smc8050/MSFS2020_Homecockpit/README.md

# MSFS2020 Homecockpit
The aim of this project was to build a home cockpit working together with Microsoft Flight Simulator 2020.
A "How to use it" will be published in future...

The PCB files are best viewed on [cadlab.io](https://cadlab.io/project/23795/main/files/PCB)
