smc8050/MSFS2020_Homecockpit/Code/README.md

# Code Directory

This directory contains the code for the Arduino and Python program which are use to send the button commands from the cockpitpanel to the Flight Simulator.

Further information will follow...
