smc8050/MSFS2020_Homecockpit/PCB/documentation/README.md

# PCB Documentation

This directry contains the documentation for all PCB relatet informations.
