smc8050/MSFS2020_Homecockpit/Code/Python/Python_code.md

# Python Code
This directory contains all the code for evaluating the inputs from th Arduino and send the correct SimConnect commands to MSFS2020
