smc8050/MSFS2020_Homecockpit/Code/Arduino/Arduino_readme.md

# Arduino Code
This directory contains all code for the arduino boards, where all the inputs are connected
