smc8050/MSFS2020_Homecockpit/Code/Pinout_Schematics/Light_panel_Pinout.pdf

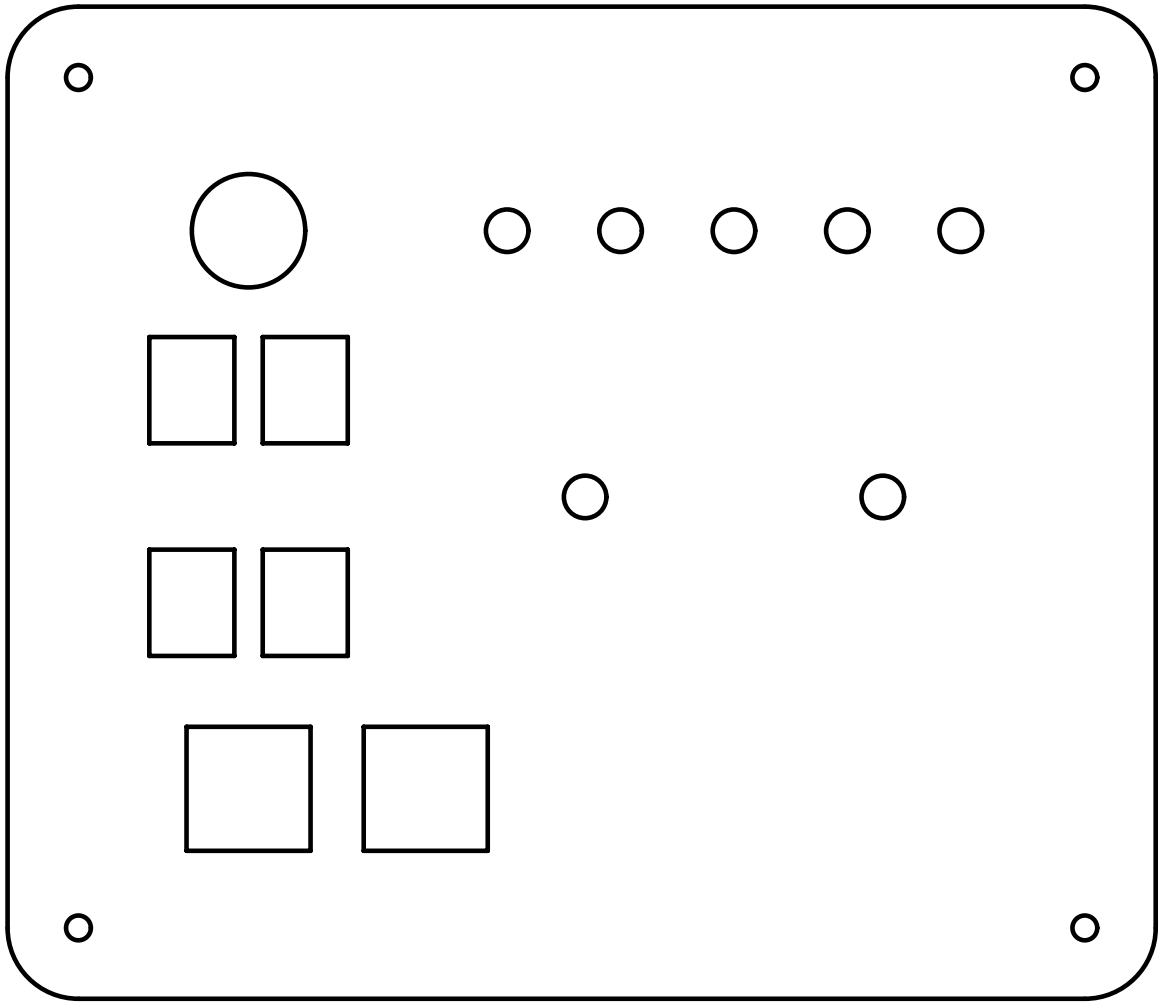
[picture p1: figure]
