smc8050/MSFS2020_Homecockpit/Code/Pinout_Schematics/Throttle_Panel_Pinout.pdf

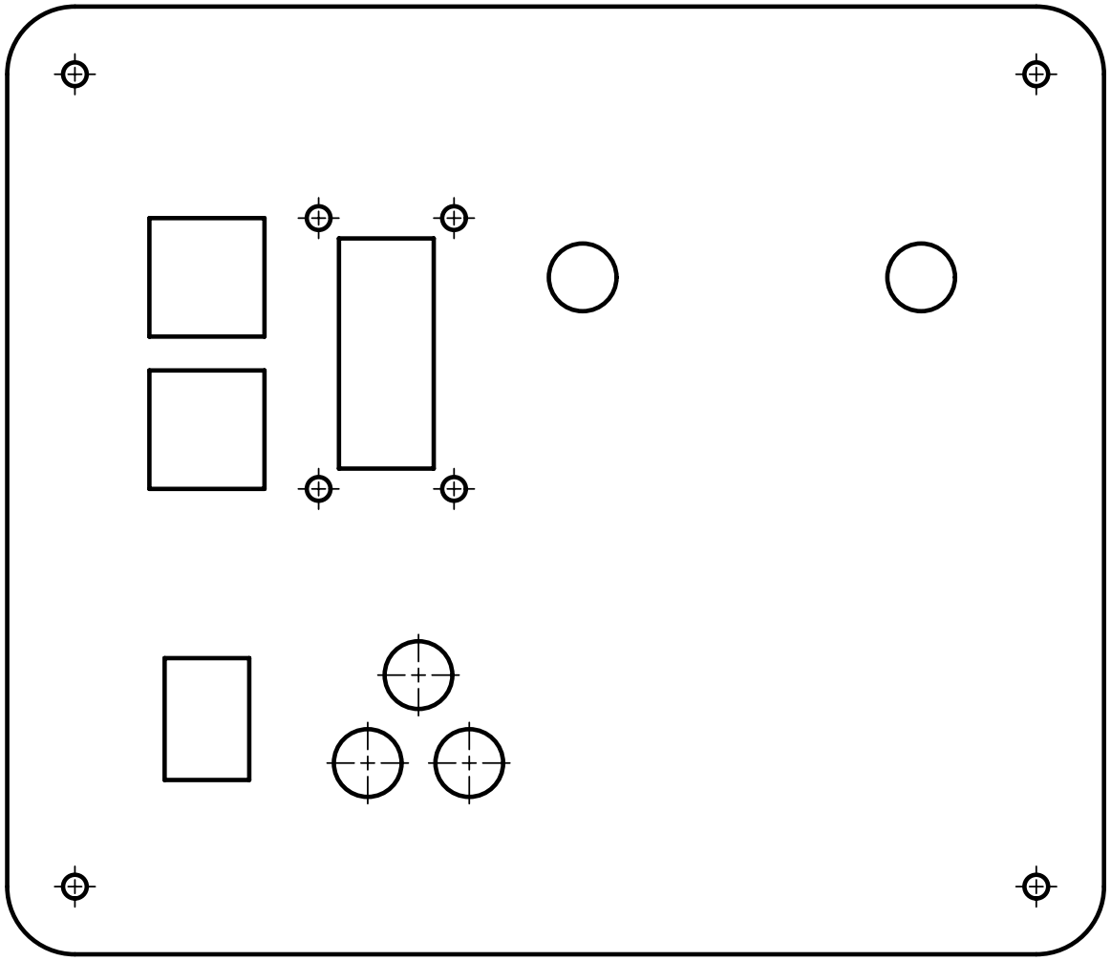
[picture p2: figure]
