smc8050/MSFS2020_Homecockpit/Code/Pinout_Schematics/Pinout_Annotated/Light_panel_Pinout.pdf

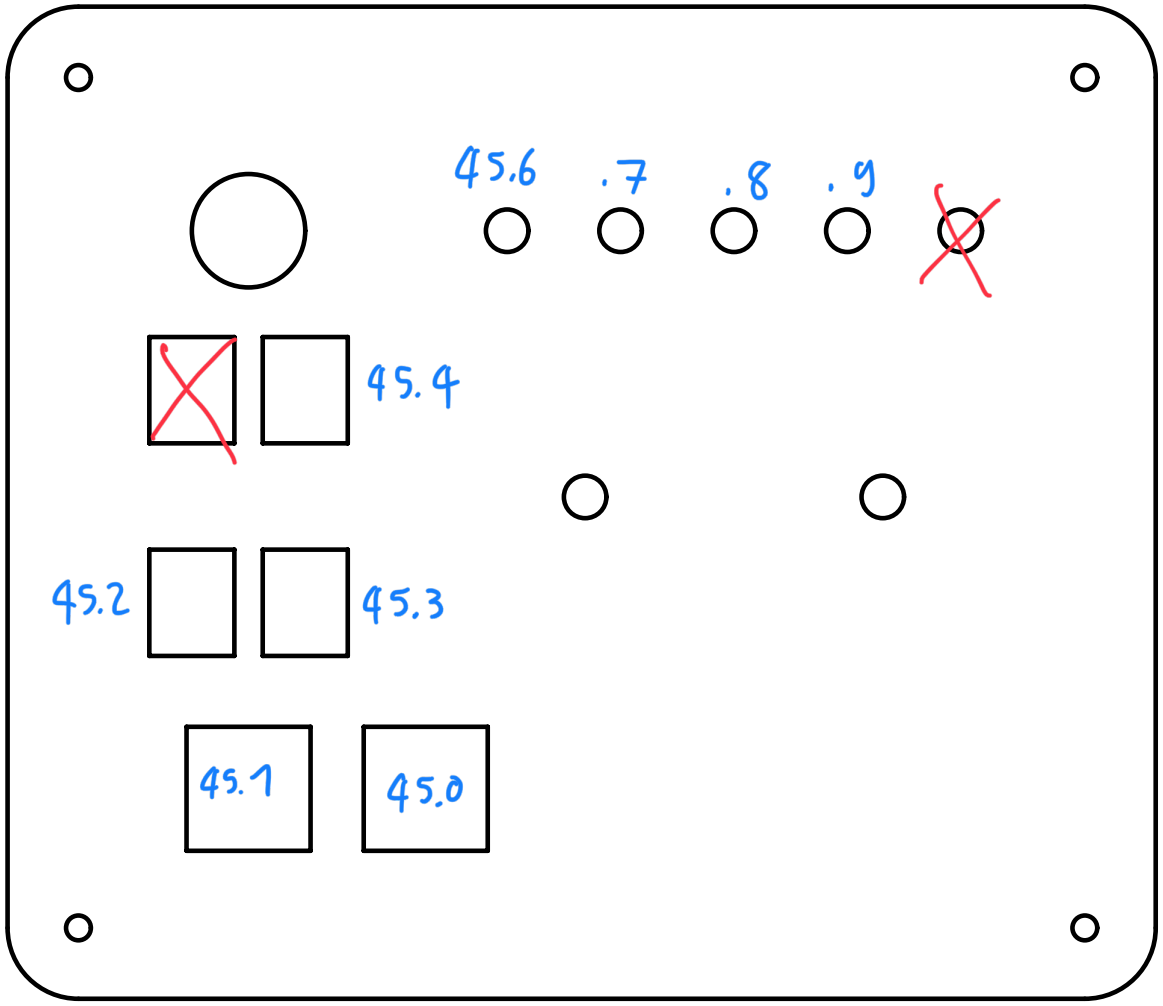
[picture p3: figure]
