smc8050/MSFS2020_Homecockpit/PCB/documentation/PCB_overview.pdf

# G1000 Panel

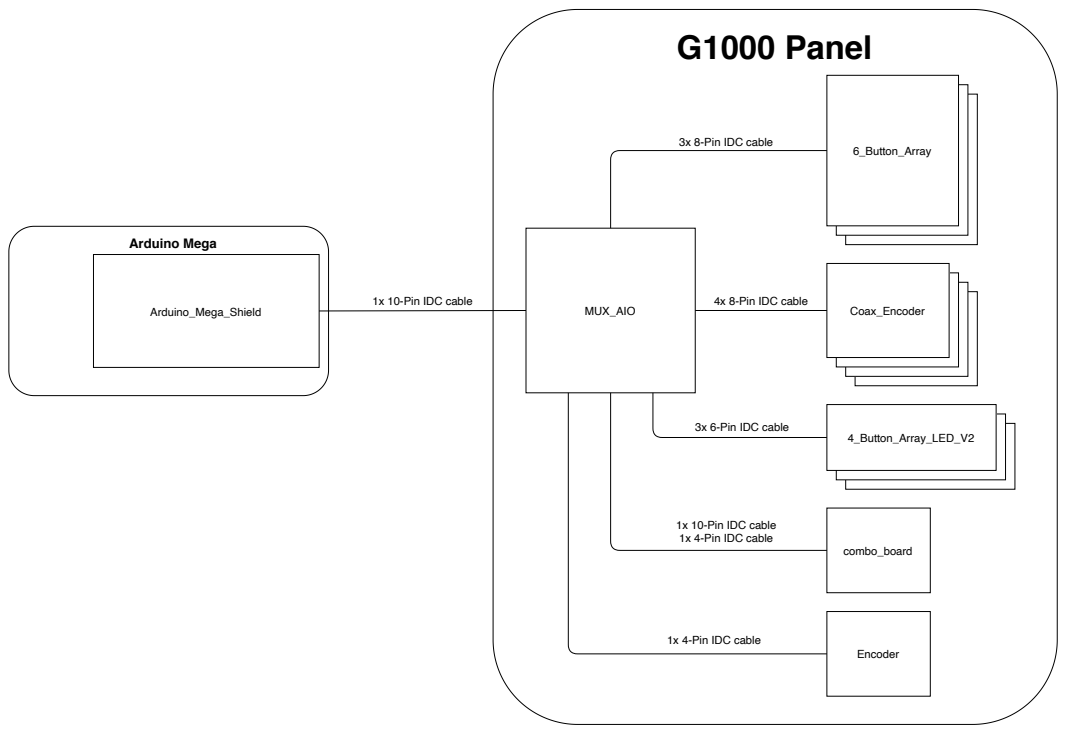
[picture p4: page 1]
4_Button_Array_LED_V2; 6_Button_Array; Coax_Encoder; combo_board; MUX_AIO; Encoder; Arduino_Mega_Shield; Arduino Mega

3x 8-Pin IDC cable

1x 10-Pin IDC cable

4x 8-Pin IDC cable

3x 6-Pin IDC cable

1x 4-Pin IDC cable
