smc8050/MSFS2020_Homecockpit/Code/Pinout_Schematics/G1000_1_Pinout.pdf

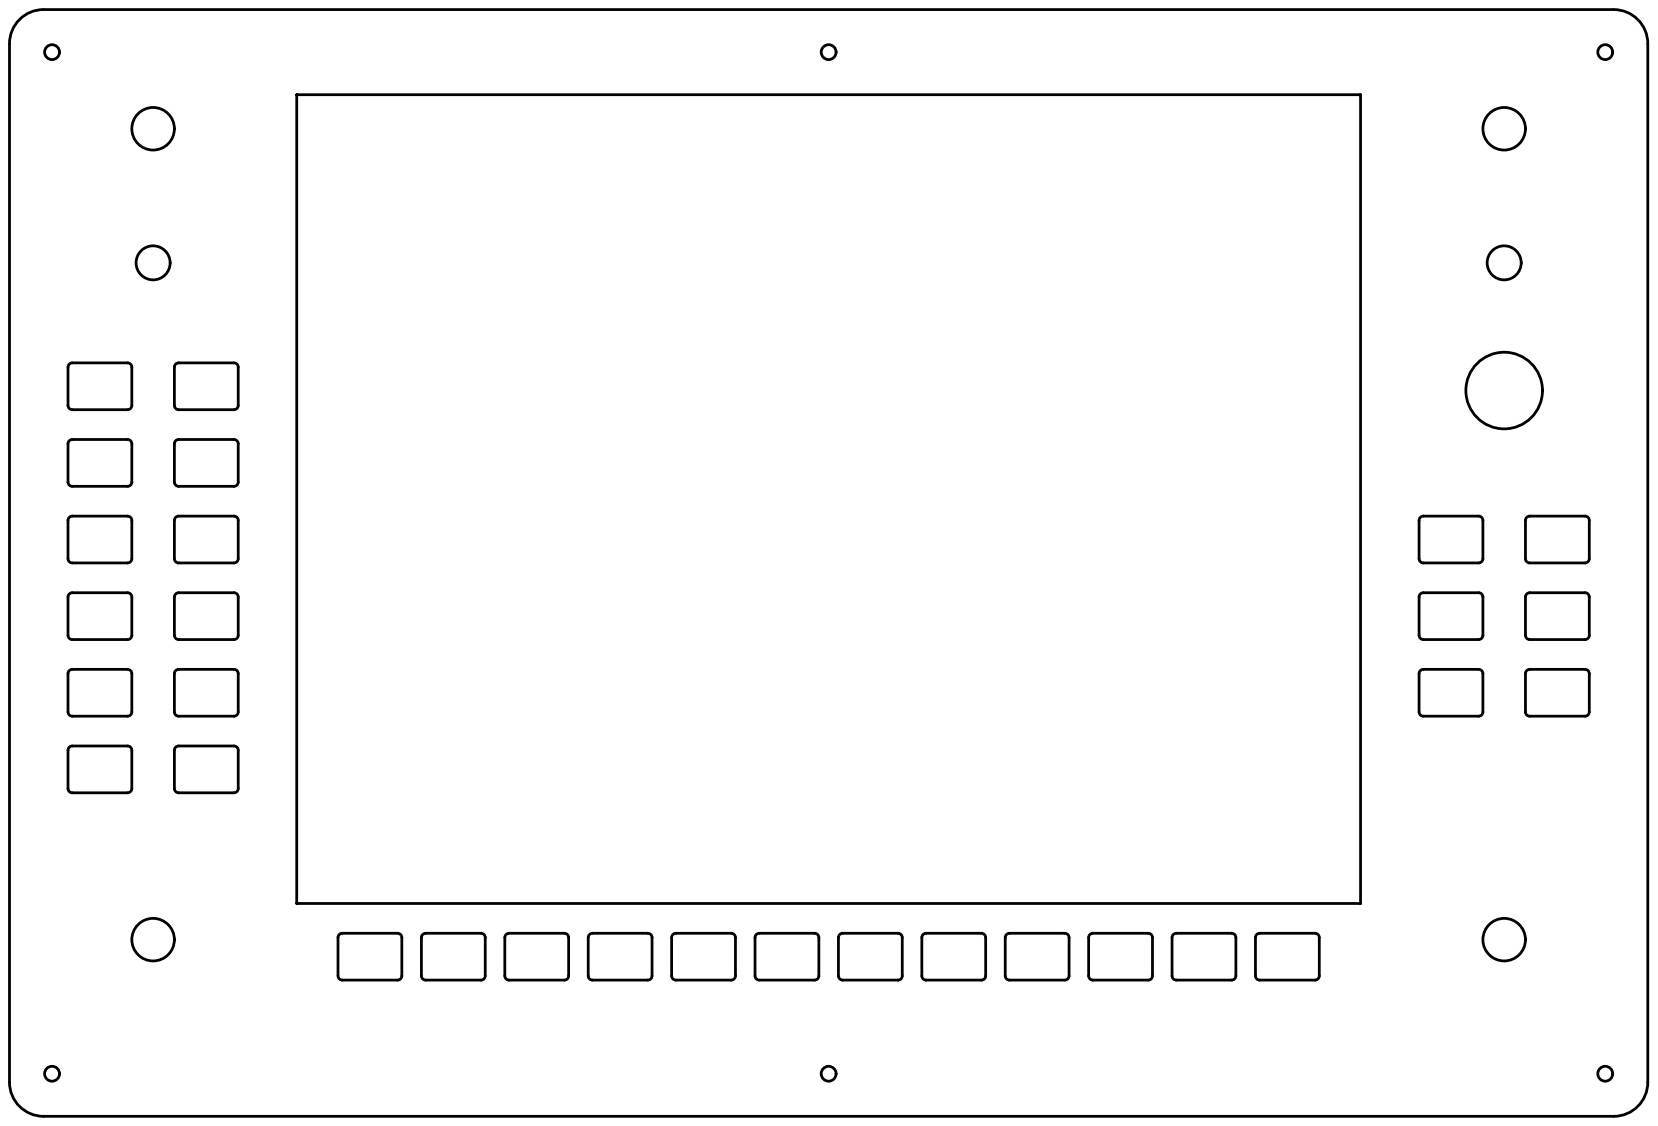
[picture p5: page 1]
