smc8050/MSFS2020_Homecockpit/Code/Pinout_Schematics/G1000_2_Pinout.pdf

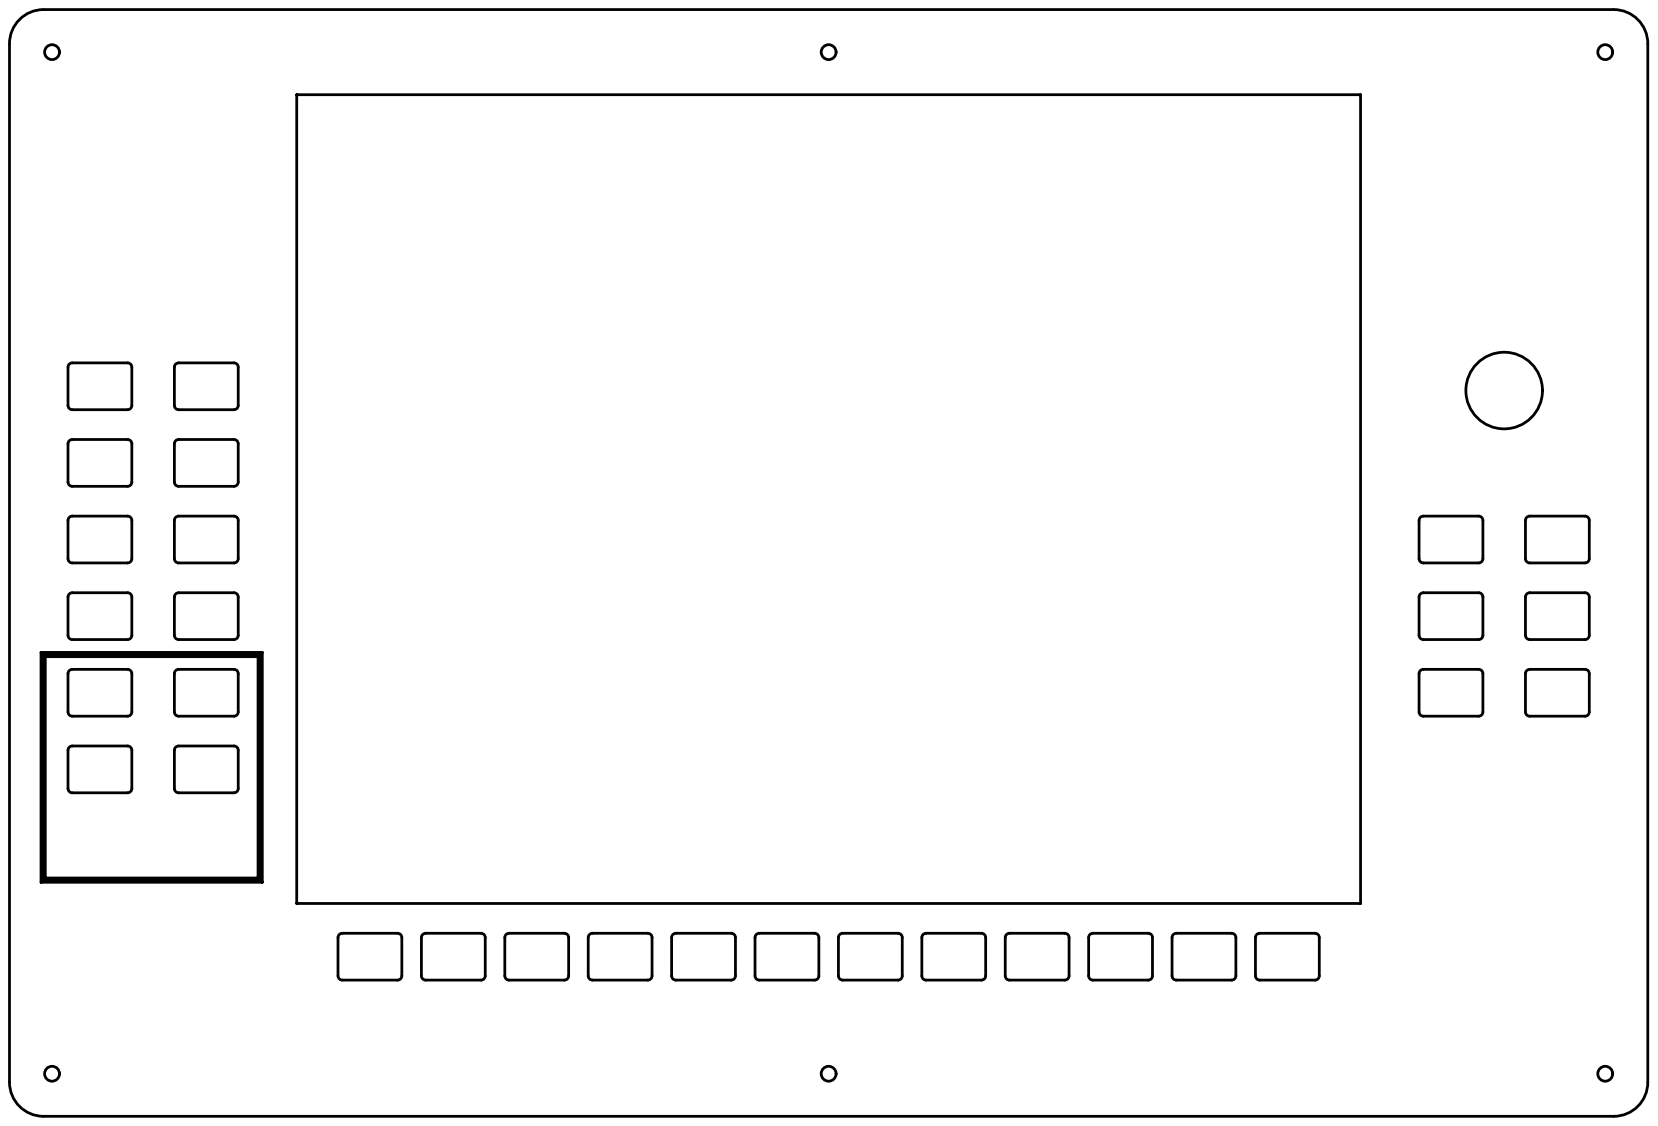
[picture p6: page 1]
