smc8050/MSFS2020_Homecockpit/Code/Pinout_Schematics/Pinout_Annotated/G1000_1_Pinout.pdf

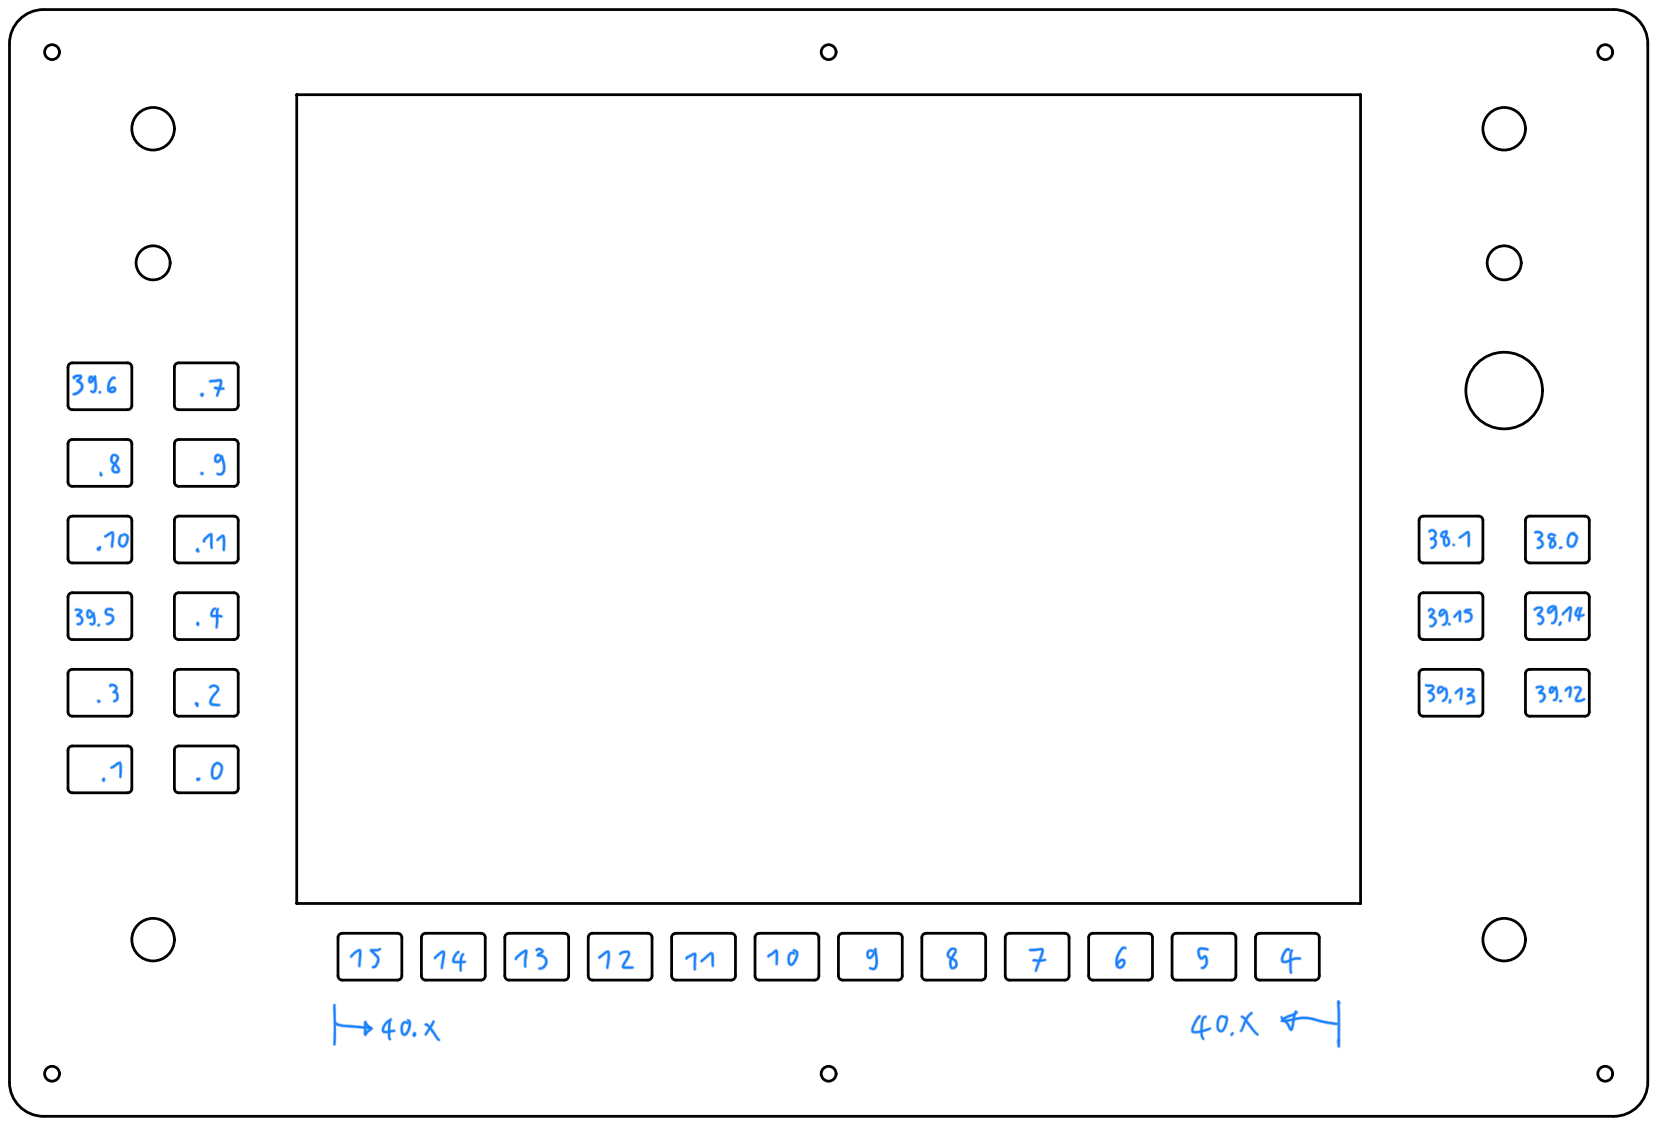
[picture p7: page 1]
