smc8050/MSFS2020_Homecockpit/Code/Pinout_Schematics/Pinout_Annotated/G1000_2_Pinout.pdf

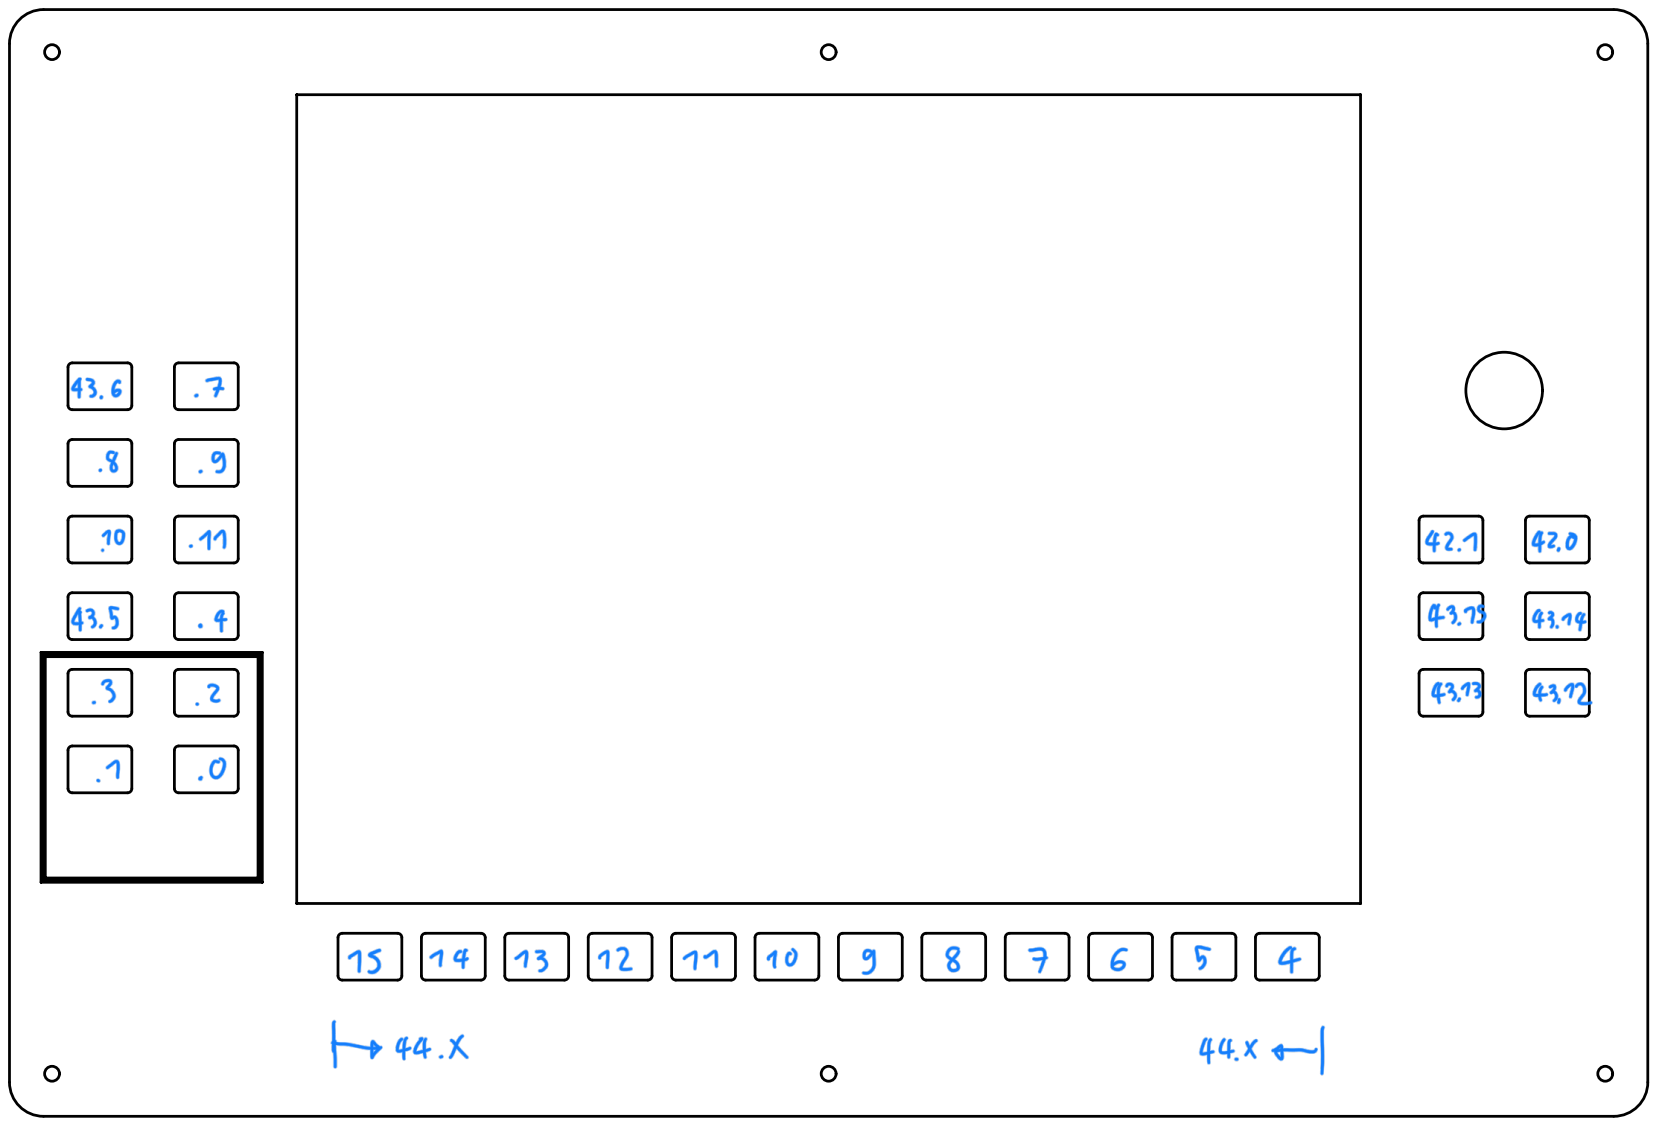
[picture p8: page 1]
