smc8050/MSFS2020_Homecockpit/PCB/projects/6_Button_Array/6_Button_Array.brd

## EAGLE design PCB/projects/6_Button_Array/6_Button_Array.brd (2021-01-24)

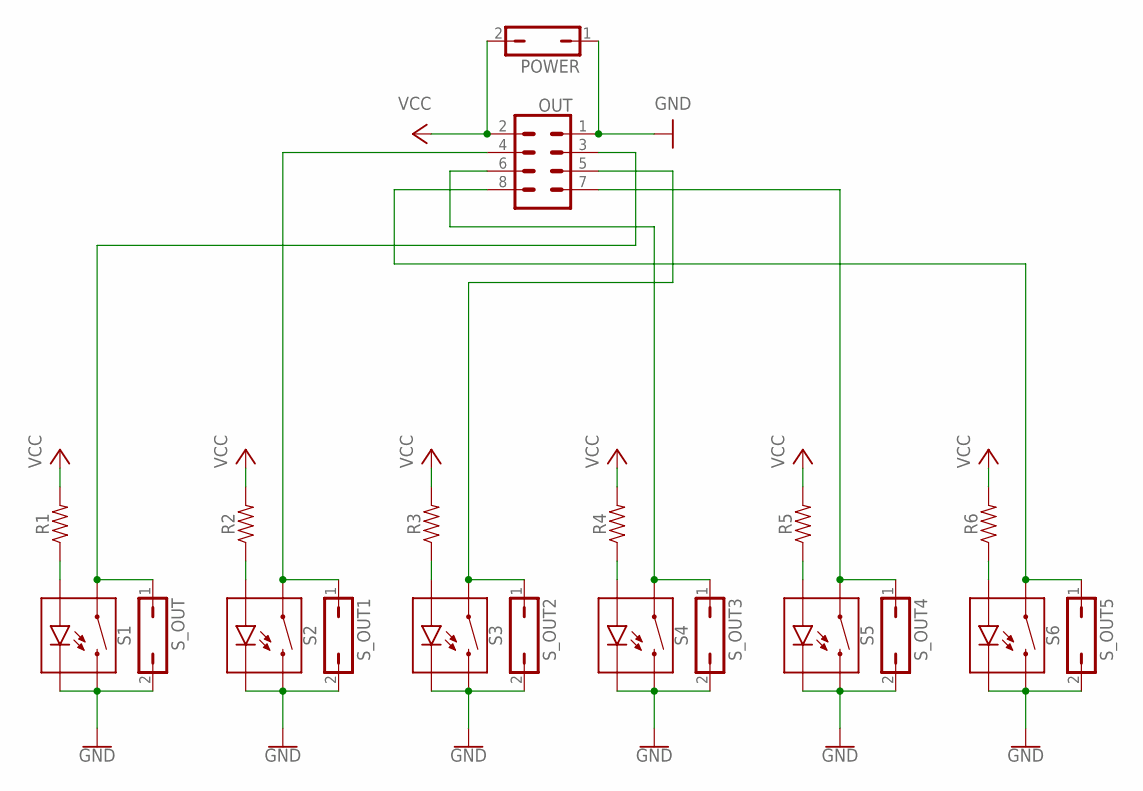
[picture p9: schematic 6_Button_Array.sch]

Parts:
OUT: CONN_04X2; 2X4
POWER: JP1Q; JP1
R1, R2, R3, R4, R5, R6: 1206
S1, S2, S3, S4, S5, S6: MOMENTARY-SWITCH-SPST-LED-PTH-12MM; TACTILE_SWITCH_LED_PTH_12MM
S_OUT, S_OUT1, S_OUT2, S_OUT3, S_OUT4, S_OUT5: JP1Q; JP1

Connections:
GND: OUT.1, POWER.1, S1.2, S1.C, S2.2, S2.C, S3.2, S3.C, S4.2, S4.C, S5.2, S5.C, S6.2, S6.C, S_OUT.2, S_OUT1.2, S_OUT2.2, S_OUT3.2, S_OUT4.2, S_OUT5.2
unnamed: R1.1, S1.A
unnamed: R2.1, S2.A
unnamed: R3.1, S3.A
unnamed: OUT.5, S3.4 (1), S_OUT2.1
unnamed: R4.1, S4.A
unnamed: OUT.6, S4.4 (1), S_OUT3.1
unnamed: R5.1, S5.A
unnamed: OUT.7, S5.4 (1), S_OUT4.1
unnamed: R6.1, S6.A
unnamed: OUT.3, S1.4 (1), S_OUT.1
unnamed: OUT.8, S6.4 (1), S_OUT5.1
unnamed: OUT.4, S2.4 (1), S_OUT1.1
VCC: OUT.2, POWER.2, R1.2, R2.2, R3.2, R4.2, R5.2, R6.2

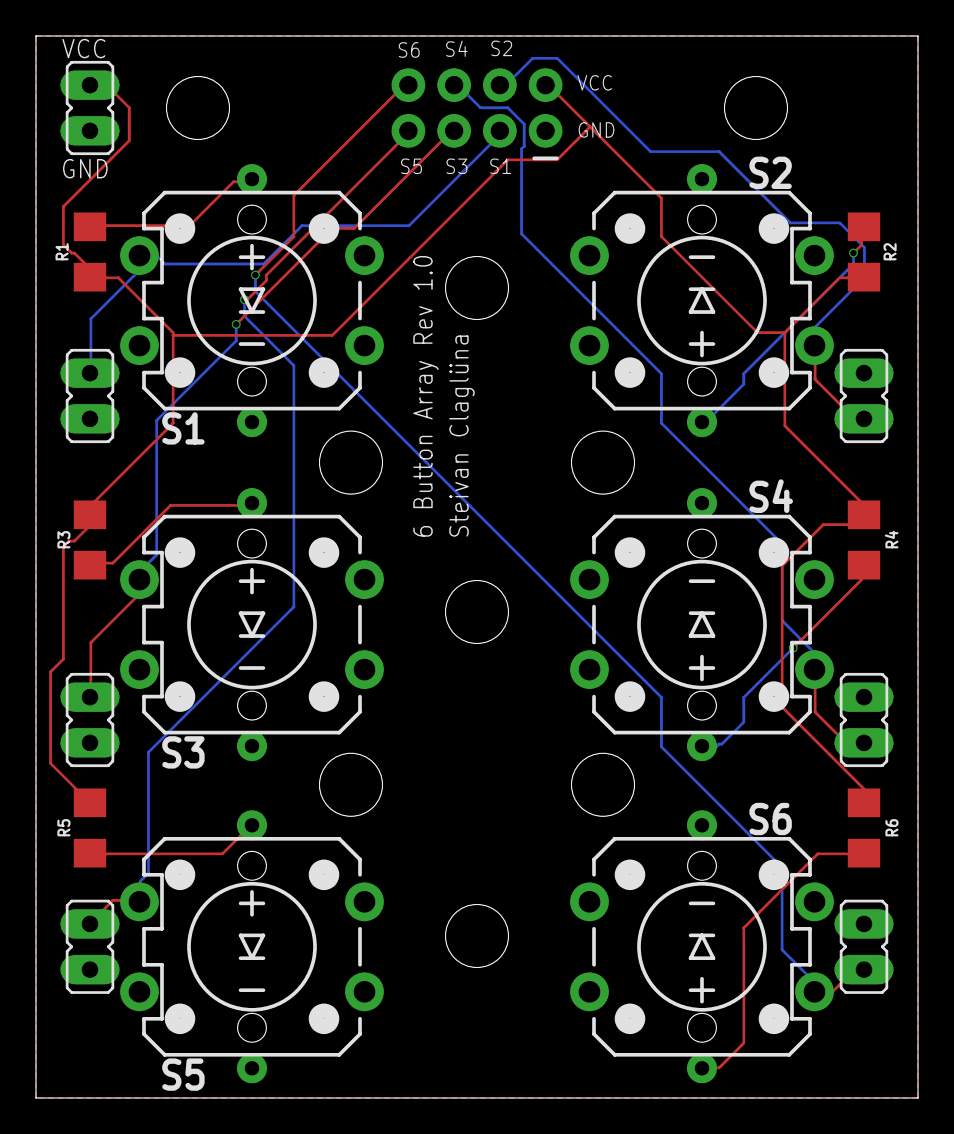
[picture p10: board 6_Button_Array.brd from above]

Board: 2 copper layers, 49.0 x 59.0 mm, 20 parts (1 on the bottom side), 14 nets.
