smc8050/MSFS2020_Homecockpit/PCB/projects/Coax_Encoder/Coax_Encoder.brd

## EAGLE design PCB/projects/Coax_Encoder/Coax_Encoder.brd (2021-01-24)

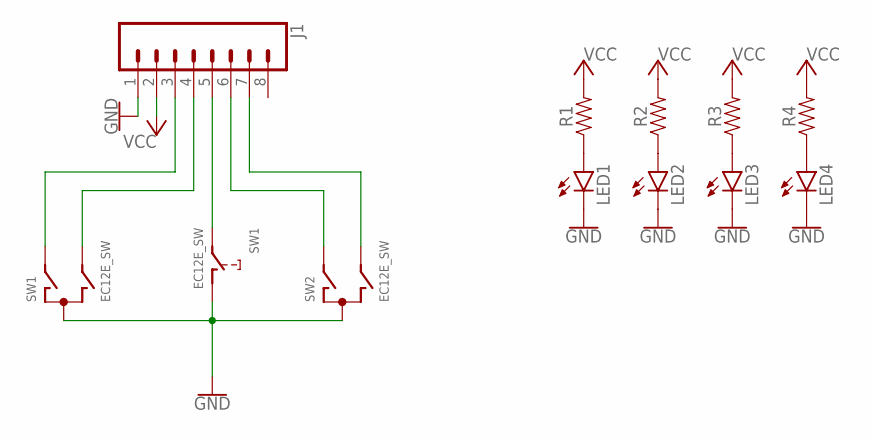
[picture p11: schematic Coax_Encoder.sch]

Parts:
J1: CONN_08"; 1X08
LED1, LED2, LED3, LED4: LED3MM
R1, R2, R3, R4: 1206
SW1, SW2: EC12E_SW; ALPS_EC12E_SW

Connections:
GND: J1.1, LED1.K (C), LED2.K (C), LED3.K (C), LED4.K (C), SW1.C, SW1.D (1), SW2.C
unnamed: J1.3, SW1.A
unnamed: J1.4, SW1.B
unnamed: J1.5, SW1.E (2)
unnamed: J1.6, SW2.A
unnamed: J1.7, SW2.B
unnamed: LED1.A, R1.1
unnamed: LED2.A, R2.1
unnamed: LED3.A, R3.1
unnamed: LED4.A, R4.1
VCC: J1.2, R1.2, R2.2, R3.2, R4.2

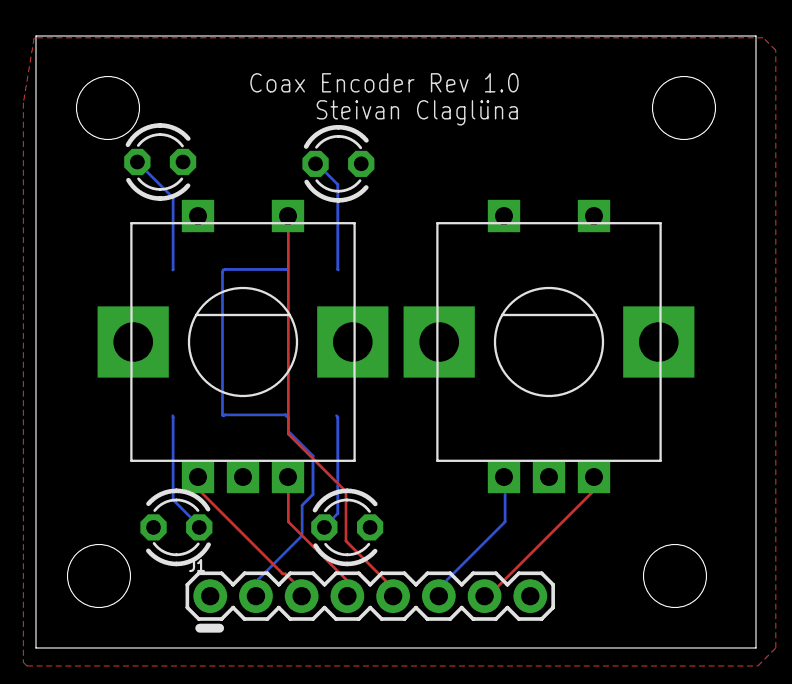
[picture p12: board Coax_Encoder.brd from above]

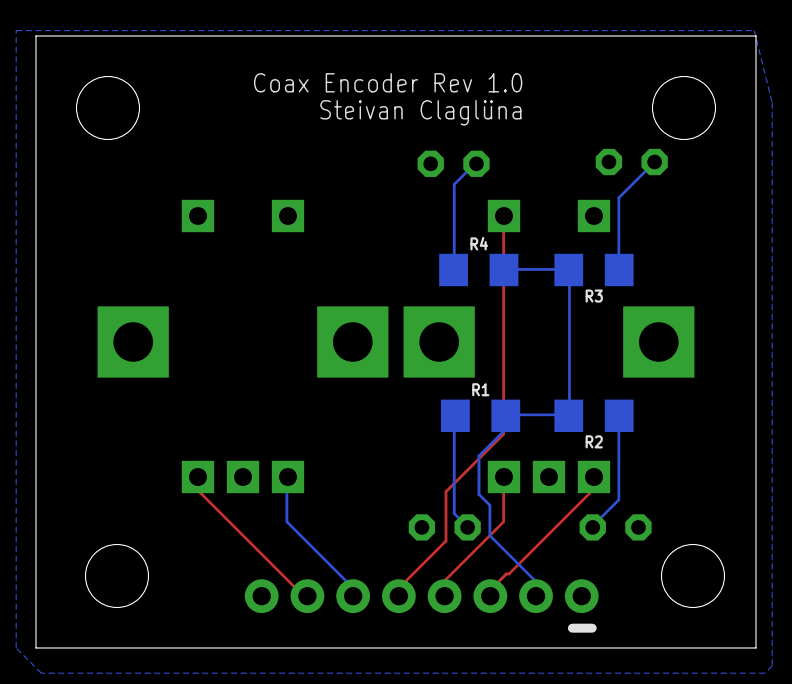
[picture p13: board Coax_Encoder.brd from below]

Board: 2 copper layers, 40.0 x 34.0 mm, 11 parts (4 on the bottom side), 11 nets.
