smc8050/MSFS2020_Homecockpit/PCB/projects/Joystick/combo_board.brd

## EAGLE design PCB/projects/Joystick/combo_board.brd (2021-01-24)

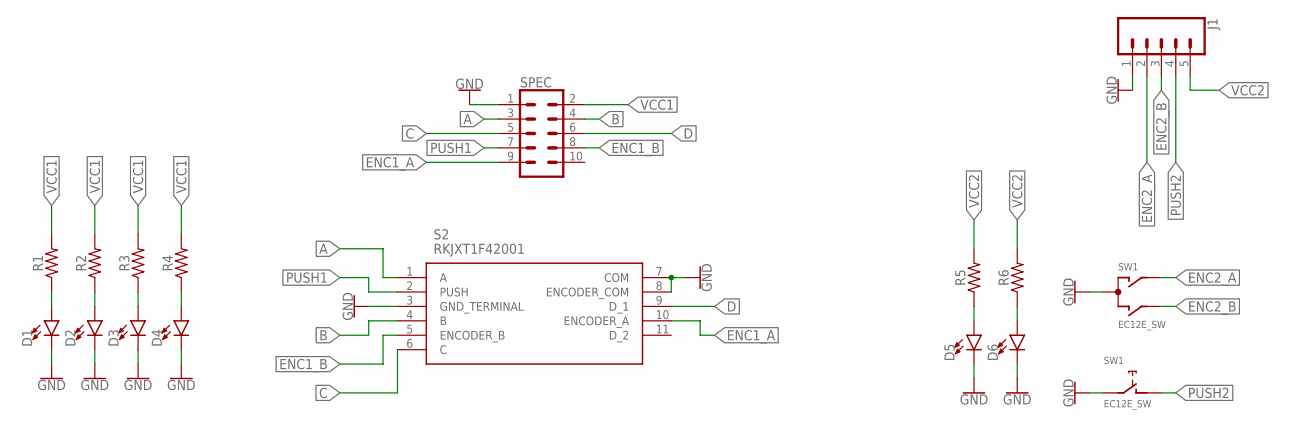
[picture p14: schematic combo_board.sch]

Parts:
D1, D2, D3, D4, D5, D6: LED-3MM-NO_SILK; LED_3MM-NS
J1: CONN_05; 1X05
R1, R2, R3, R4, R5, R6: 1206
S2: RKJXT1F42001
SPEC: CONN_05X2PTH; 2X5
SW1: EC12E_SW; ALPS_EC12E_SW

Connections:
A: S2.1 (A), SPEC.3
B: S2.4 (B), SPEC.4
C: S2.6 (C), SPEC.5
D: S2.9 (D_1), SPEC.6
ENC1_A: S2.10 (ENCODER_A), SPEC.9
ENC1_B: S2.5 (ENCODER_B), SPEC.8
ENC2_A: J1.2, SW1.A
ENC2_B: J1.3, SW1.B
GND: D1.K (C), D2.K (C), D3.K (C), D4.K (C), D5.K (C), D6.K (C), J1.1, S2.3 (GND_TERMINAL), S2.7 (COM), S2.8 (ENCODER_COM), SPEC.1, SW1.C, SW1.E (2)
unnamed: D1.A, R1.1
unnamed: D2.A, R2.1
unnamed: D3.A, R3.1
unnamed: D4.A, R4.1
unnamed: D5.A, R5.1
unnamed: D6.A, R6.1
PUSH1: S2.2 (PUSH), SPEC.7
PUSH2: J1.4, SW1.D (1)
VCC1: R1.2, R2.2, R3.2, R4.2, SPEC.2
VCC2: J1.5, R5.2, R6.2

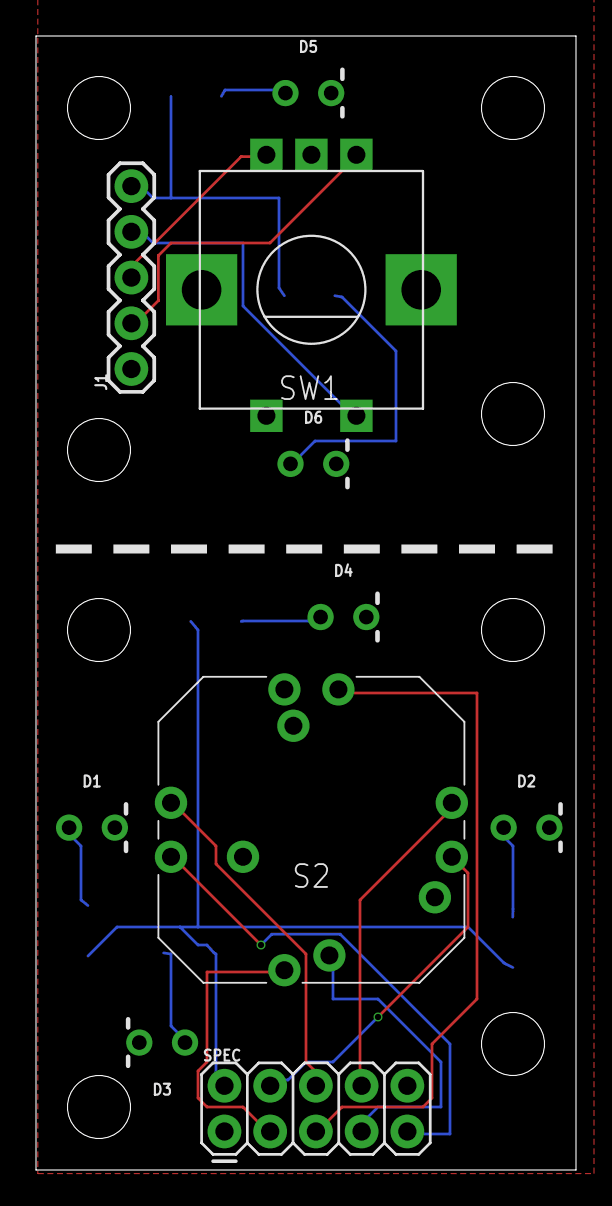
[picture p15: board combo_board.brd from above]

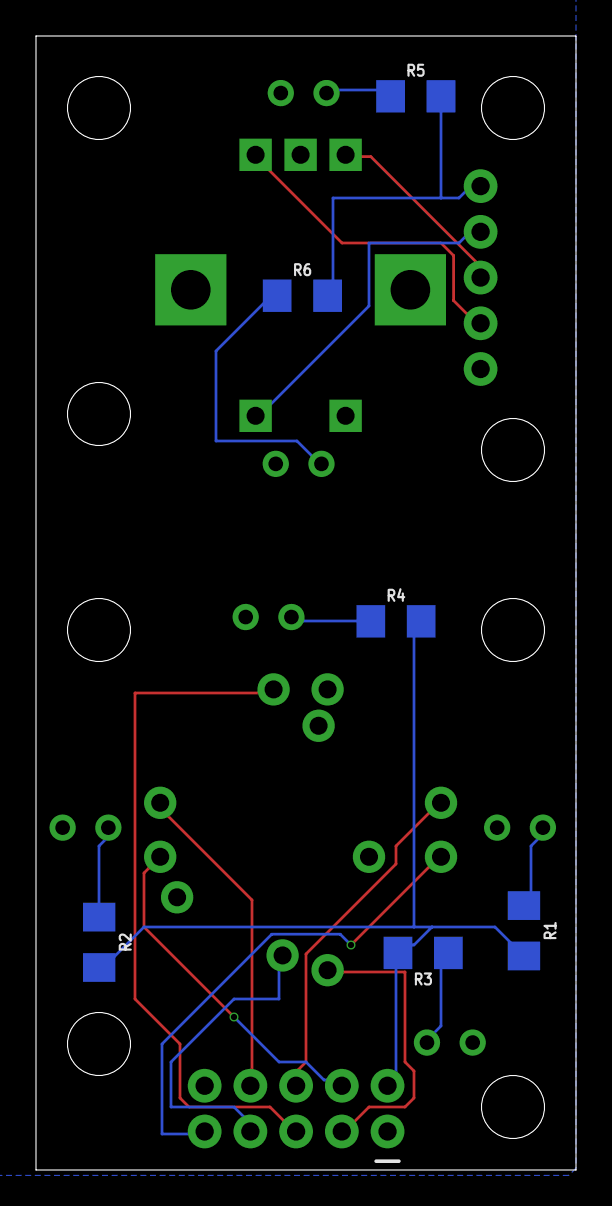
[picture p16: board combo_board.brd from below]

Board: 2 copper layers, 30.0 x 63.0 mm, 16 parts (6 on the bottom side), 19 nets.
