smc8050/MSFS2020_Homecockpit/PCB/projects/MUX_AIO/MUX_Adapter.brd

## EAGLE design PCB/projects/MUX_AIO/MUX_Adapter.brd (2021-01-24)

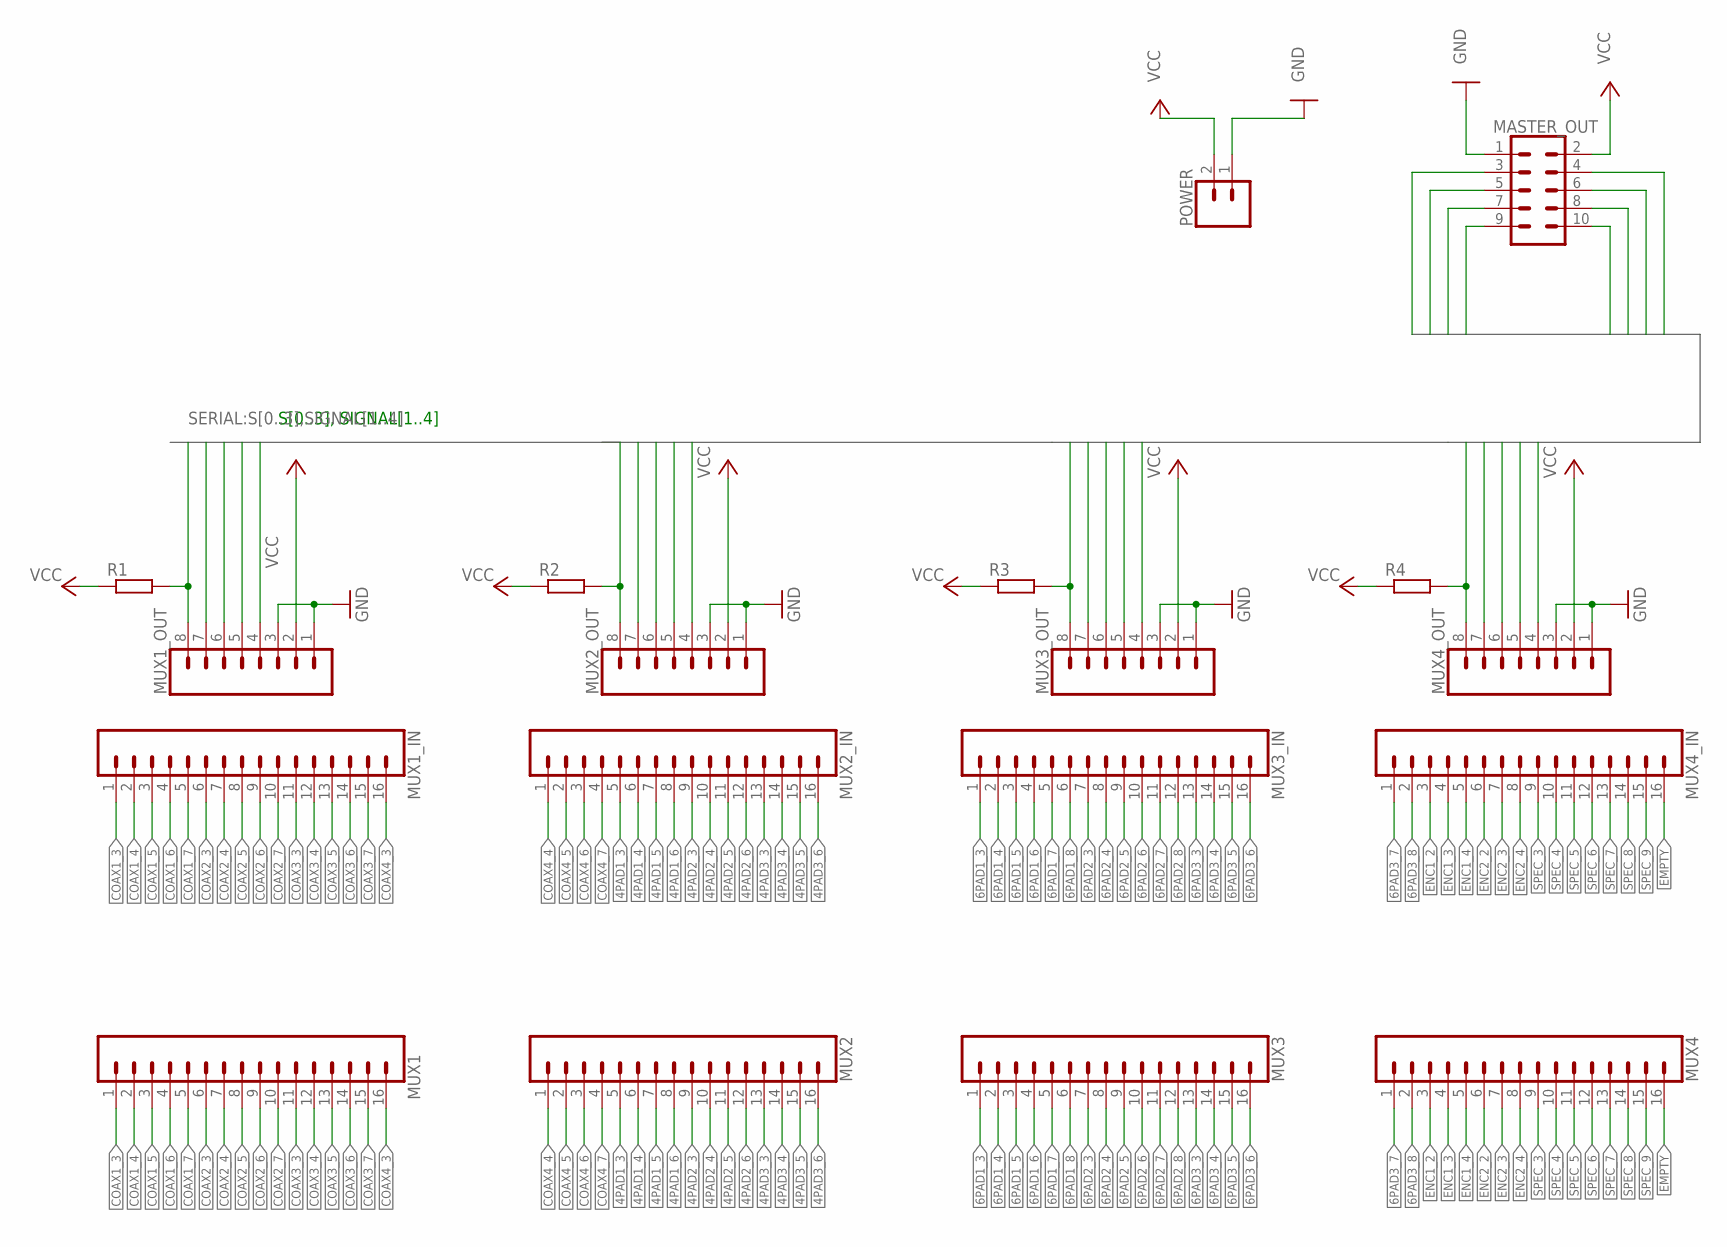
[picture p17: schematic MUX_Adapter.sch, sheet 1, MUX Routing]

Parts:
MASTER_OUT: CONN_05X2SHD-NS; 2X5-SHROUDED-NS
MUX1, MUX1_IN, MUX2, MUX2_IN, MUX3, MUX3_IN, MUX4, MUX4_IN: CONN_16; 1X16
MUX1_OUT, MUX2_OUT, MUX3_OUT, MUX4_OUT: CONN_08"; 1X08
POWER: CONN_02; 1X02
R1, R2, R3, R4: R-EU_0207/10; 0207/10

Connections:
4PAD1_3: MUX2.5, MUX2_IN.5; also elsewhere on the board
4PAD1_4: MUX2.6, MUX2_IN.6; also elsewhere on the board
4PAD1_5: MUX2.7, MUX2_IN.7; also elsewhere on the board
4PAD1_6: MUX2.8, MUX2_IN.8; also elsewhere on the board
4PAD2_3: MUX2.9, MUX2_IN.9; also elsewhere on the board
4PAD2_4: MUX2.10, MUX2_IN.10; also elsewhere on the board
4PAD2_5: MUX2.11, MUX2_IN.11; also elsewhere on the board
4PAD2_6: MUX2.12, MUX2_IN.12; also elsewhere on the board
4PAD3_3: MUX2.13, MUX2_IN.13; also elsewhere on the board
4PAD3_4: MUX2.14, MUX2_IN.14; also elsewhere on the board
4PAD3_5: MUX2.15, MUX2_IN.15; also elsewhere on the board
4PAD3_6: MUX2.16, MUX2_IN.16; also elsewhere on the board
6PAD1_3: MUX3.1, MUX3_IN.1; also elsewhere on the board
6PAD1_4: MUX3.2, MUX3_IN.2; also elsewhere on the board
6PAD1_5: MUX3.3, MUX3_IN.3; also elsewhere on the board
6PAD1_6: MUX3.4, MUX3_IN.4; also elsewhere on the board
6PAD1_7: MUX3.5, MUX3_IN.5; also elsewhere on the board
6PAD1_8: MUX3.6, MUX3_IN.6; also elsewhere on the board
6PAD2_3: MUX3.7, MUX3_IN.7; also elsewhere on the board
6PAD2_4: MUX3.8, MUX3_IN.8; also elsewhere on the board
6PAD2_5: MUX3.9, MUX3_IN.9; also elsewhere on the board
6PAD2_6: MUX3.10, MUX3_IN.10; also elsewhere on the board
6PAD2_7: MUX3.11, MUX3_IN.11; also elsewhere on the board
6PAD2_8: MUX3.12, MUX3_IN.12; also elsewhere on the board
6PAD3_3: MUX3.13, MUX3_IN.13; also elsewhere on the board
6PAD3_4: MUX3.14, MUX3_IN.14; also elsewhere on the board
6PAD3_5: MUX3.15, MUX3_IN.15; also elsewhere on the board
6PAD3_6: MUX3.16, MUX3_IN.16; also elsewhere on the board
6PAD3_7: MUX4.1, MUX4_IN.1; also elsewhere on the board
6PAD3_8: MUX4.2, MUX4_IN.2; also elsewhere on the board
COAX1_3: MUX1.1, MUX1_IN.1; also elsewhere on the board
COAX1_4: MUX1.2, MUX1_IN.2; also elsewhere on the board
COAX1_5: MUX1.3, MUX1_IN.3; also elsewhere on the board
COAX1_6: MUX1.4, MUX1_IN.4; also elsewhere on the board
COAX1_7: MUX1.5, MUX1_IN.5; also elsewhere on the board
COAX2_3: MUX1.6, MUX1_IN.6; also elsewhere on the board
COAX2_4: MUX1.7, MUX1_IN.7; also elsewhere on the board
COAX2_5: MUX1.8, MUX1_IN.8; also elsewhere on the board
COAX2_6: MUX1.9, MUX1_IN.9; also elsewhere on the board
COAX2_7: MUX1.10, MUX1_IN.10; also elsewhere on the board
COAX3_3: MUX1.11, MUX1_IN.11; also elsewhere on the board
COAX3_4: MUX1.12, MUX1_IN.12; also elsewhere on the board
COAX3_5: MUX1.13, MUX1_IN.13; also elsewhere on the board
COAX3_6: MUX1.14, MUX1_IN.14; also elsewhere on the board
COAX3_7: MUX1.15, MUX1_IN.15; also elsewhere on the board
COAX4_3: MUX1.16, MUX1_IN.16; also elsewhere on the board
COAX4_4: MUX2.1, MUX2_IN.1; also elsewhere on the board
COAX4_5: MUX2.2, MUX2_IN.2; also elsewhere on the board
COAX4_6: MUX2.3, MUX2_IN.3; also elsewhere on the board
COAX4_7: MUX2.4, MUX2_IN.4; also elsewhere on the board
EMPTY: MUX4.16, MUX4_IN.16
ENC1_2: MUX4.3, MUX4_IN.3; also elsewhere on the board
ENC1_3: MUX4.4, MUX4_IN.4; also elsewhere on the board
ENC1_4: MUX4.5, MUX4_IN.5; also elsewhere on the board
ENC2_2: MUX4.6, MUX4_IN.6; also elsewhere on the board
ENC2_3: MUX4.7, MUX4_IN.7; also elsewhere on the board
ENC2_4: MUX4.8, MUX4_IN.8; also elsewhere on the board
GND: MASTER_OUT.1, MUX1_OUT.1, MUX1_OUT.3, MUX2_OUT.1, MUX2_OUT.3, MUX3_OUT.1, MUX3_OUT.3, MUX4_OUT.1, MUX4_OUT.3, POWER.1; also elsewhere on the board
S0: MASTER_OUT.3, MUX1_OUT.4, MUX2_OUT.4, MUX3_OUT.4, MUX4_OUT.4
S1: MASTER_OUT.4, MUX1_OUT.5, MUX2_OUT.5, MUX3_OUT.5, MUX4_OUT.5
S2: MASTER_OUT.5, MUX1_OUT.6, MUX2_OUT.6, MUX3_OUT.6, MUX4_OUT.6
S3: MASTER_OUT.6, MUX1_OUT.7, MUX2_OUT.7, MUX3_OUT.7, MUX4_OUT.7
SIGNAL1: MASTER_OUT.7, MUX4_OUT.8, R4.2
SIGNAL2: MASTER_OUT.8, MUX3_OUT.8, R3.2
SIGNAL3: MASTER_OUT.9, MUX2_OUT.8, R2.2
SIGNAL4: MASTER_OUT.10, MUX1_OUT.8, R1.2
SPEC_3: MUX4.9, MUX4_IN.9; also elsewhere on the board
SPEC_4: MUX4.10, MUX4_IN.10; also elsewhere on the board
SPEC_5: MUX4.11, MUX4_IN.11; also elsewhere on the board
SPEC_6: MUX4.12, MUX4_IN.12; also elsewhere on the board
SPEC_7: MUX4.13, MUX4_IN.13; also elsewhere on the board
SPEC_8: MUX4.14, MUX4_IN.14; also elsewhere on the board
SPEC_9: MUX4.15, MUX4_IN.15; also elsewhere on the board
VCC: MASTER_OUT.2, MUX1_OUT.2, MUX2_OUT.2, MUX3_OUT.2, MUX4_OUT.2, POWER.2, R1.1, R2.1, R3.1, R4.1; also elsewhere on the board

Notes on the sheet:
S[0..3], SIGNAL[1..4]

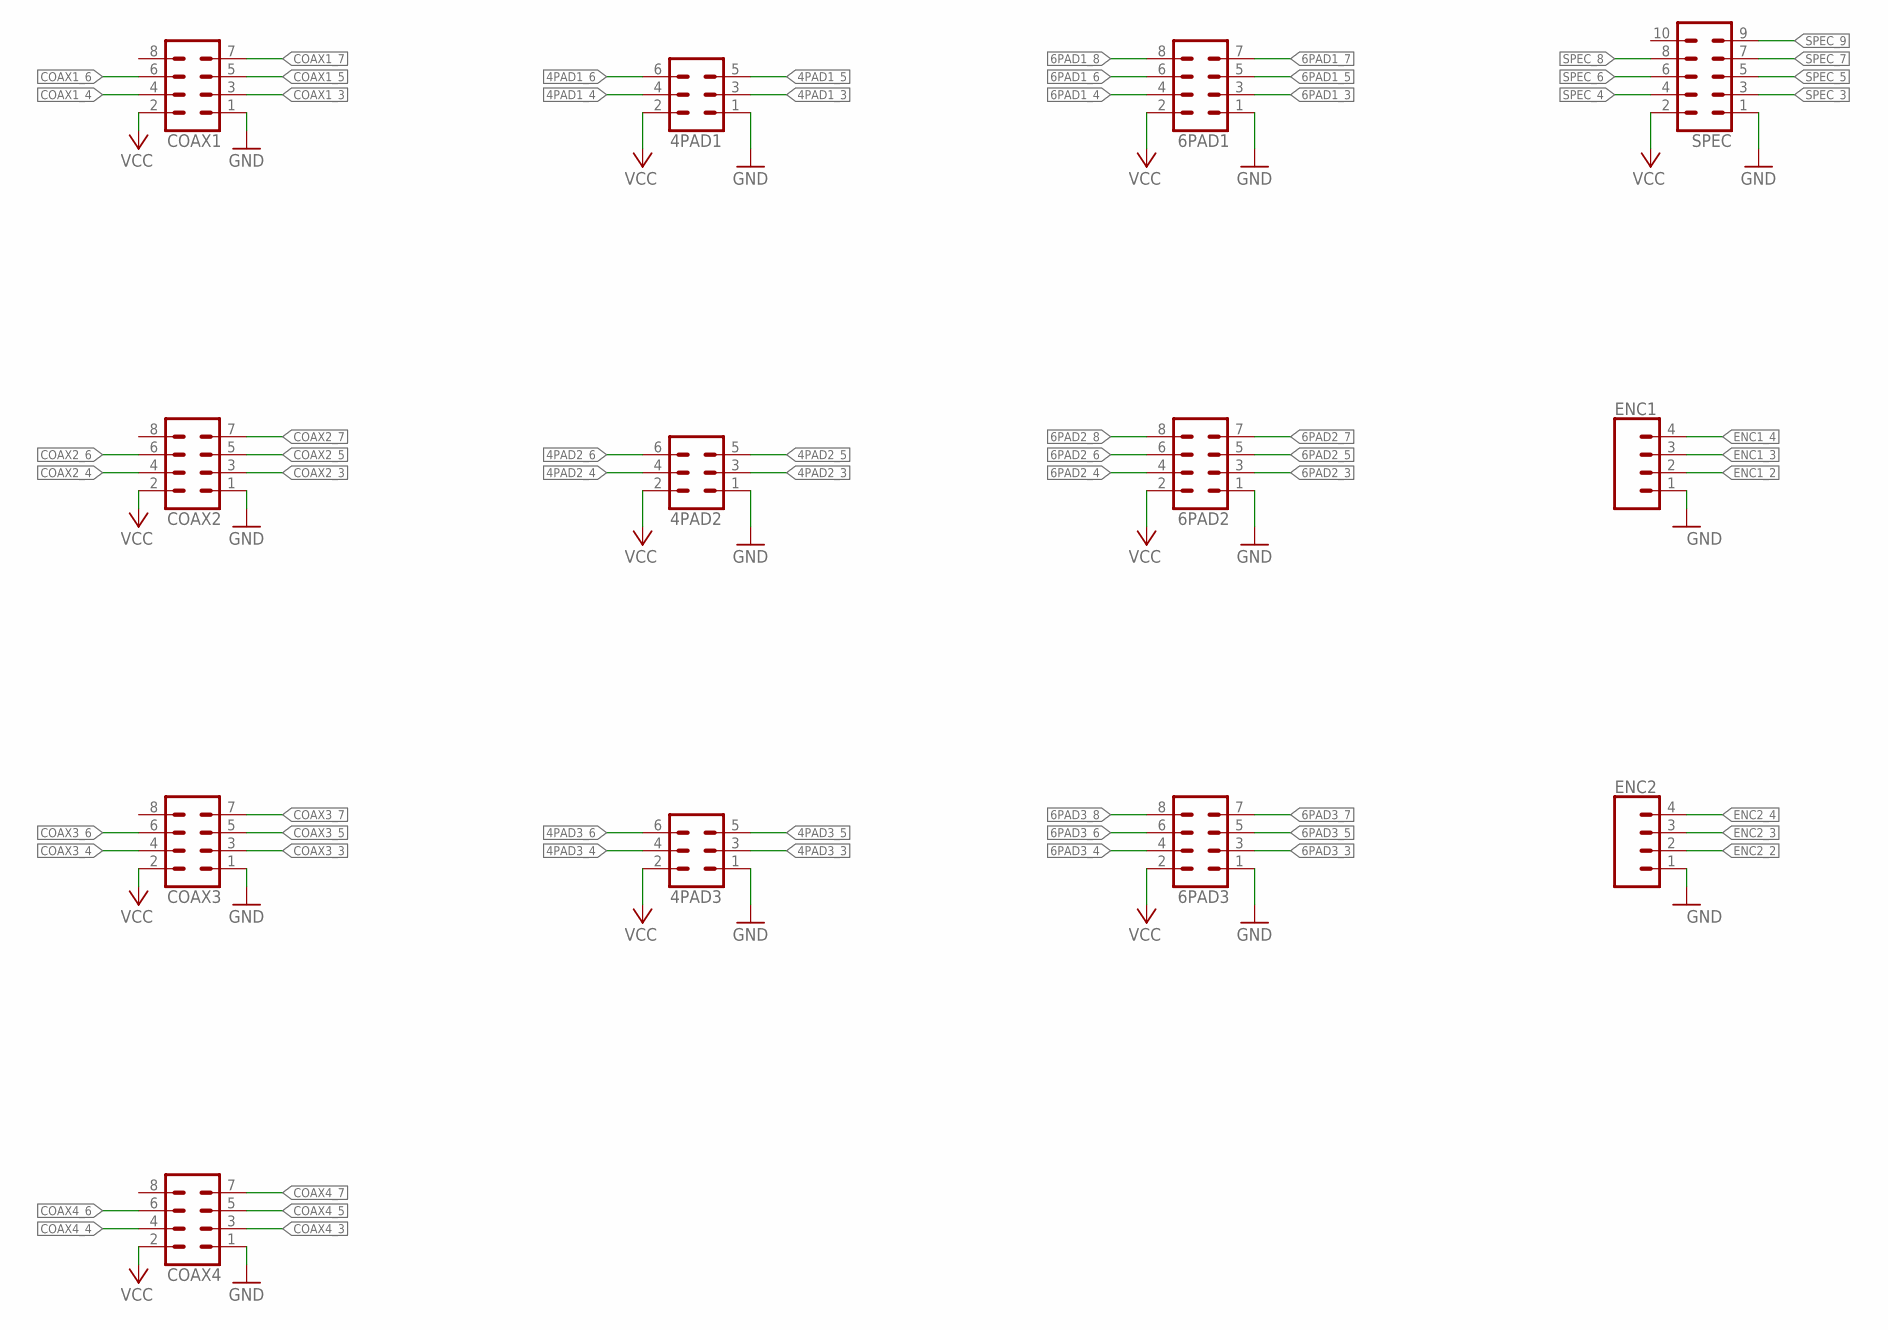
[picture p18: schematic MUX_Adapter.sch, sheet 2, Connecors]

Parts:
4PAD1, 4PAD2, 4PAD3: CONN_03X2NO_SILK; 2X3-NS
6PAD1, 6PAD2, 6PAD3: CONN_04X2; 2X4
COAX1, COAX2, COAX3, COAX4: CONN_04X2; 2X4
ENC1, ENC2: CONN_04PTH; 1X04
SPEC: CONN_05X2PTH; 2X5

Connections:
4PAD1_3: 4PAD1.3; also elsewhere on the board
4PAD1_4: 4PAD1.4; also elsewhere on the board
4PAD1_5: 4PAD1.5; also elsewhere on the board
4PAD1_6: 4PAD1.6; also elsewhere on the board
4PAD2_3: 4PAD2.3; also elsewhere on the board
4PAD2_4: 4PAD2.4; also elsewhere on the board
4PAD2_5: 4PAD2.5; also elsewhere on the board
4PAD2_6: 4PAD2.6; also elsewhere on the board
4PAD3_3: 4PAD3.3; also elsewhere on the board
4PAD3_4: 4PAD3.4; also elsewhere on the board
4PAD3_5: 4PAD3.5; also elsewhere on the board
4PAD3_6: 4PAD3.6; also elsewhere on the board
6PAD1_3: 6PAD1.3; also elsewhere on the board
6PAD1_4: 6PAD1.4; also elsewhere on the board
6PAD1_5: 6PAD1.5; also elsewhere on the board
6PAD1_6: 6PAD1.6; also elsewhere on the board
6PAD1_7: 6PAD1.7; also elsewhere on the board
6PAD1_8: 6PAD1.8; also elsewhere on the board
6PAD2_3: 6PAD2.3; also elsewhere on the board
6PAD2_4: 6PAD2.4; also elsewhere on the board
6PAD2_5: 6PAD2.5; also elsewhere on the board
6PAD2_6: 6PAD2.6; also elsewhere on the board
6PAD2_7: 6PAD2.7; also elsewhere on the board
6PAD2_8: 6PAD2.8; also elsewhere on the board
6PAD3_3: 6PAD3.3; also elsewhere on the board
6PAD3_4: 6PAD3.4; also elsewhere on the board
6PAD3_5: 6PAD3.5; also elsewhere on the board
6PAD3_6: 6PAD3.6; also elsewhere on the board
6PAD3_7: 6PAD3.7; also elsewhere on the board
6PAD3_8: 6PAD3.8; also elsewhere on the board
COAX1_3: COAX1.3; also elsewhere on the board
COAX1_4: COAX1.4; also elsewhere on the board
COAX1_5: COAX1.5; also elsewhere on the board
COAX1_6: COAX1.6; also elsewhere on the board
COAX1_7: COAX1.7; also elsewhere on the board
COAX2_3: COAX2.3; also elsewhere on the board
COAX2_4: COAX2.4; also elsewhere on the board
COAX2_5: COAX2.5; also elsewhere on the board
COAX2_6: COAX2.6; also elsewhere on the board
COAX2_7: COAX2.7; also elsewhere on the board
COAX3_3: COAX3.3; also elsewhere on the board
COAX3_4: COAX3.4; also elsewhere on the board
COAX3_5: COAX3.5; also elsewhere on the board
COAX3_6: COAX3.6; also elsewhere on the board
COAX3_7: COAX3.7; also elsewhere on the board
COAX4_3: COAX4.3; also elsewhere on the board
COAX4_4: COAX4.4; also elsewhere on the board
COAX4_5: COAX4.5; also elsewhere on the board
COAX4_6: COAX4.6; also elsewhere on the board
COAX4_7: COAX4.7; also elsewhere on the board
ENC1_2: ENC1.2; also elsewhere on the board
ENC1_3: ENC1.3; also elsewhere on the board
ENC1_4: ENC1.4; also elsewhere on the board
ENC2_2: ENC2.2; also elsewhere on the board
ENC2_3: ENC2.3; also elsewhere on the board
ENC2_4: ENC2.4; also elsewhere on the board
GND: 4PAD1.1, 4PAD2.1, 4PAD3.1, 6PAD1.1, 6PAD2.1, 6PAD3.1, COAX1.1, COAX2.1, COAX3.1, COAX4.1, ENC1.1, ENC2.1, SPEC.1; also elsewhere on the board
SPEC_3: SPEC.3; also elsewhere on the board
SPEC_4: SPEC.4; also elsewhere on the board
SPEC_5: SPEC.5; also elsewhere on the board
SPEC_6: SPEC.6; also elsewhere on the board
SPEC_7: SPEC.7; also elsewhere on the board
SPEC_8: SPEC.8; also elsewhere on the board
SPEC_9: SPEC.9; also elsewhere on the board
VCC: 4PAD1.2, 4PAD2.2, 4PAD3.2, 6PAD1.2, 6PAD2.2, 6PAD3.2, COAX1.2, COAX2.2, COAX3.2, COAX4.2, SPEC.2; also elsewhere on the board

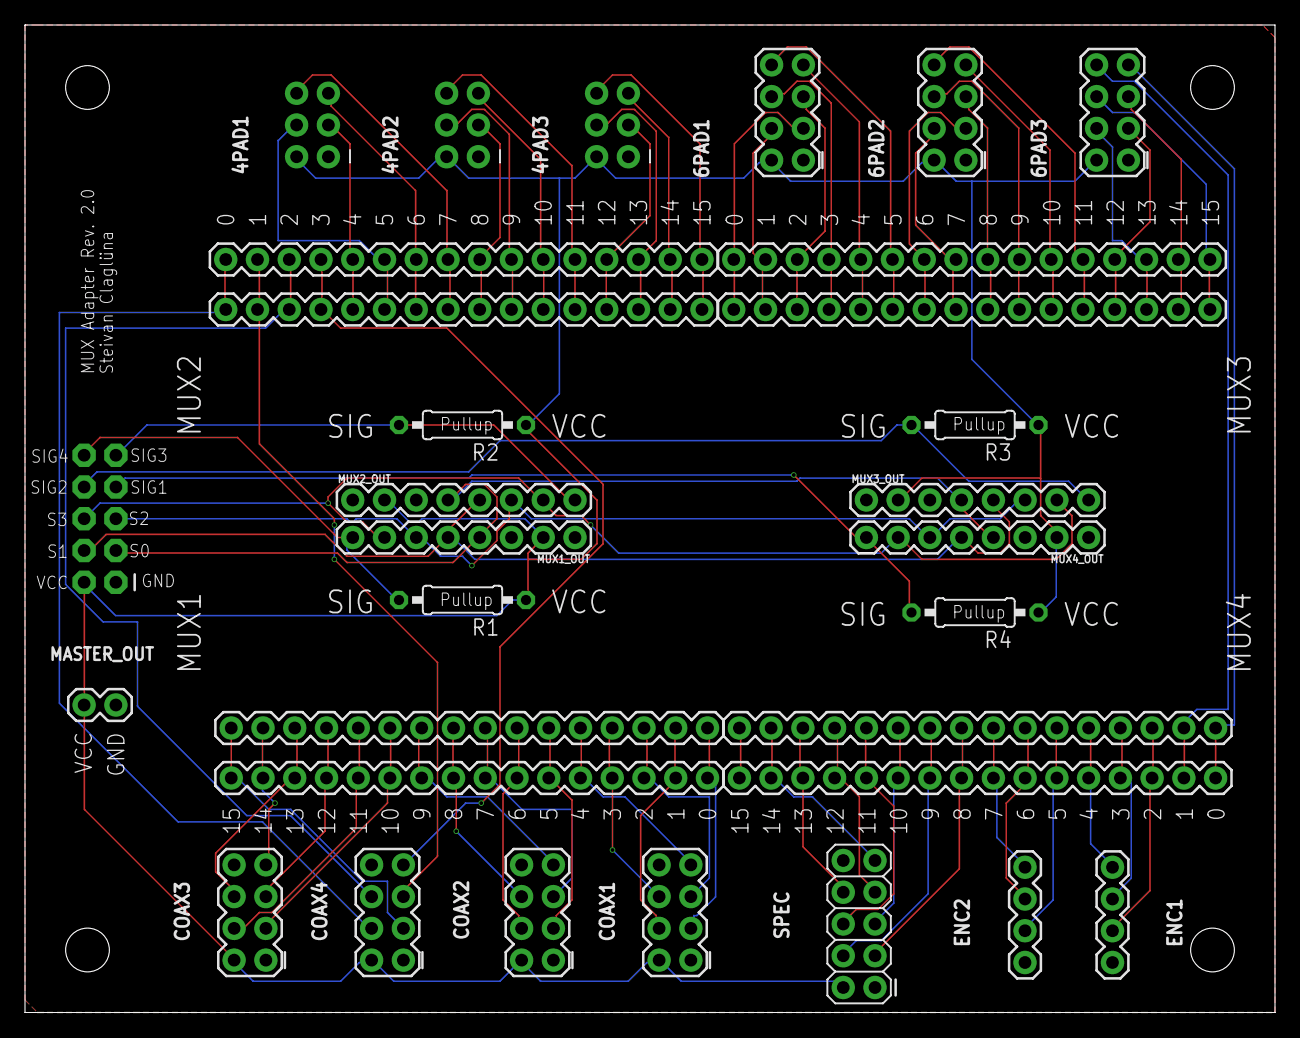
[picture p19: board MUX_Adapter.brd from above]

Board: 2 copper layers, 100.0 x 79.0 mm, 31 parts (0 on the bottom side), 74 nets.
