smc8050/MSFS2020_Homecockpit/PCB/projects/4_Button_Array_LED/4_Button_Array_LED.brd

## EAGLE design PCB/projects/4_Button_Array_LED/4_Button_Array_LED.brd (2021-01-24)

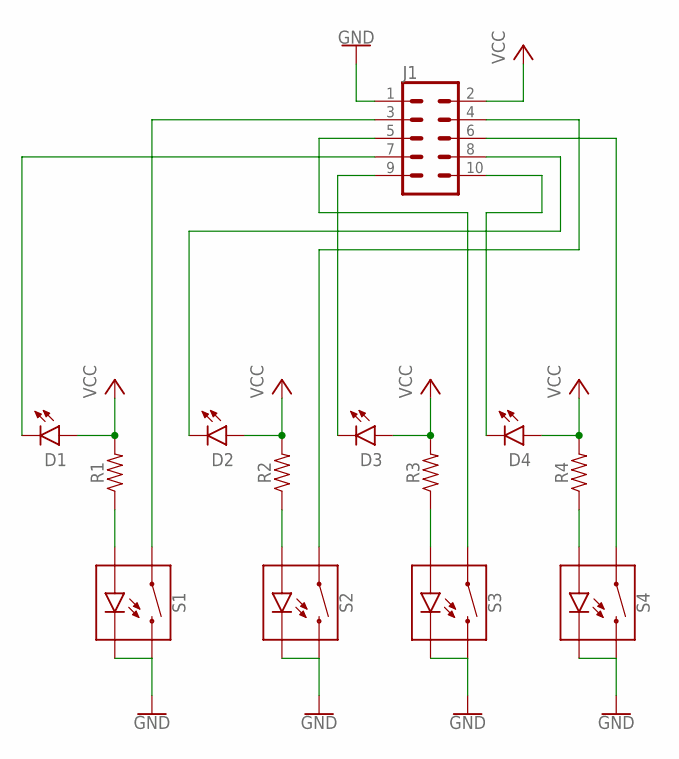
[picture p20: schematic 4_Button_Array_LED.sch]

Parts:
D1, D2, D3, D4: LED3MM; LED_3MM
J1: CONN_05X2SHD-NS; 2X5-SHROUDED-NS
R1, R2, R3, R4: 1206
S1, S2, S3, S4: MOMENTARY-SWITCH-SPST-LED-PTH-12MM; TACTILE_SWITCH_LED_PTH_12MM

Connections:
GND: J1.1, S1.2, S1.C, S2.2, S2.C, S3.2, S3.C, S4.2, S4.C
unnamed: R2.1, S2.A
unnamed: R1.1, S1.A
unnamed: R3.1, S3.A
unnamed: R4.1, S4.A
unnamed: J1.3, S1.4 (1)
unnamed: J1.4, S2.4 (1)
unnamed: J1.5, S3.4 (1)
unnamed: J1.6, S4.4 (1)
unnamed: D1.K (C), J1.7
unnamed: D2.K (C), J1.8
unnamed: D3.K (C), J1.9
unnamed: D4.K (C), J1.10
VCC: D1.A, D2.A, D3.A, D4.A, J1.2, R1.2, R2.2, R3.2, R4.2

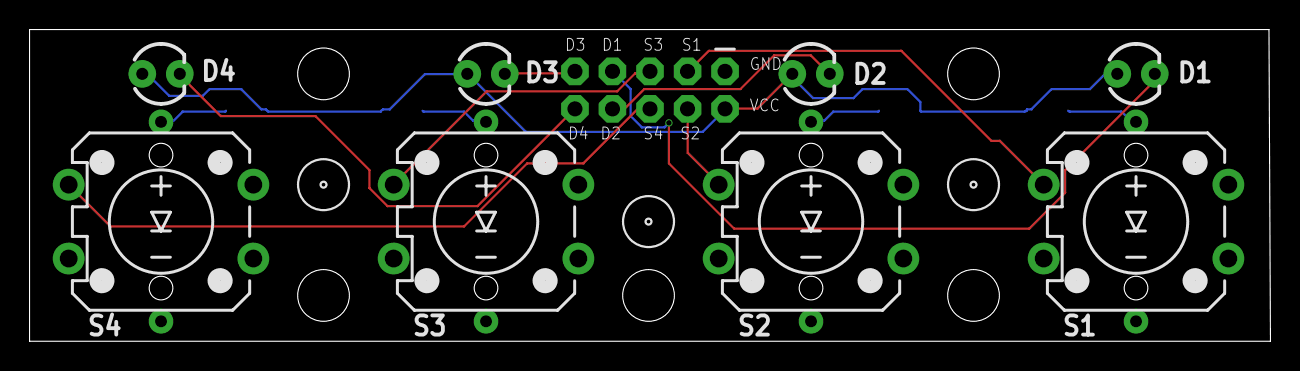
[picture p21: board 4_Button_Array_LED.brd from above]

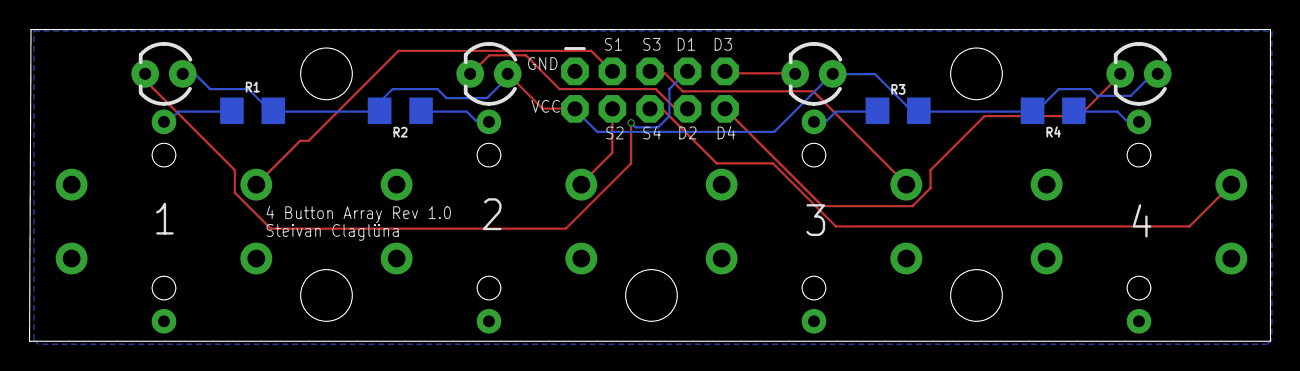
[picture p22: board 4_Button_Array_LED.brd from below]

Board: 2 copper layers, 84.0 x 21.1 mm, 13 parts (4 on the bottom side), 14 nets.
