smc8050/MSFS2020_Homecockpit/PCB/projects/4_Button_Array_LED_V2/4_Button_Array_LED_V2.brd

## EAGLE design PCB/projects/4_Button_Array_LED_V2/4_Button_Array_LED_V2.brd (2021-01-24)

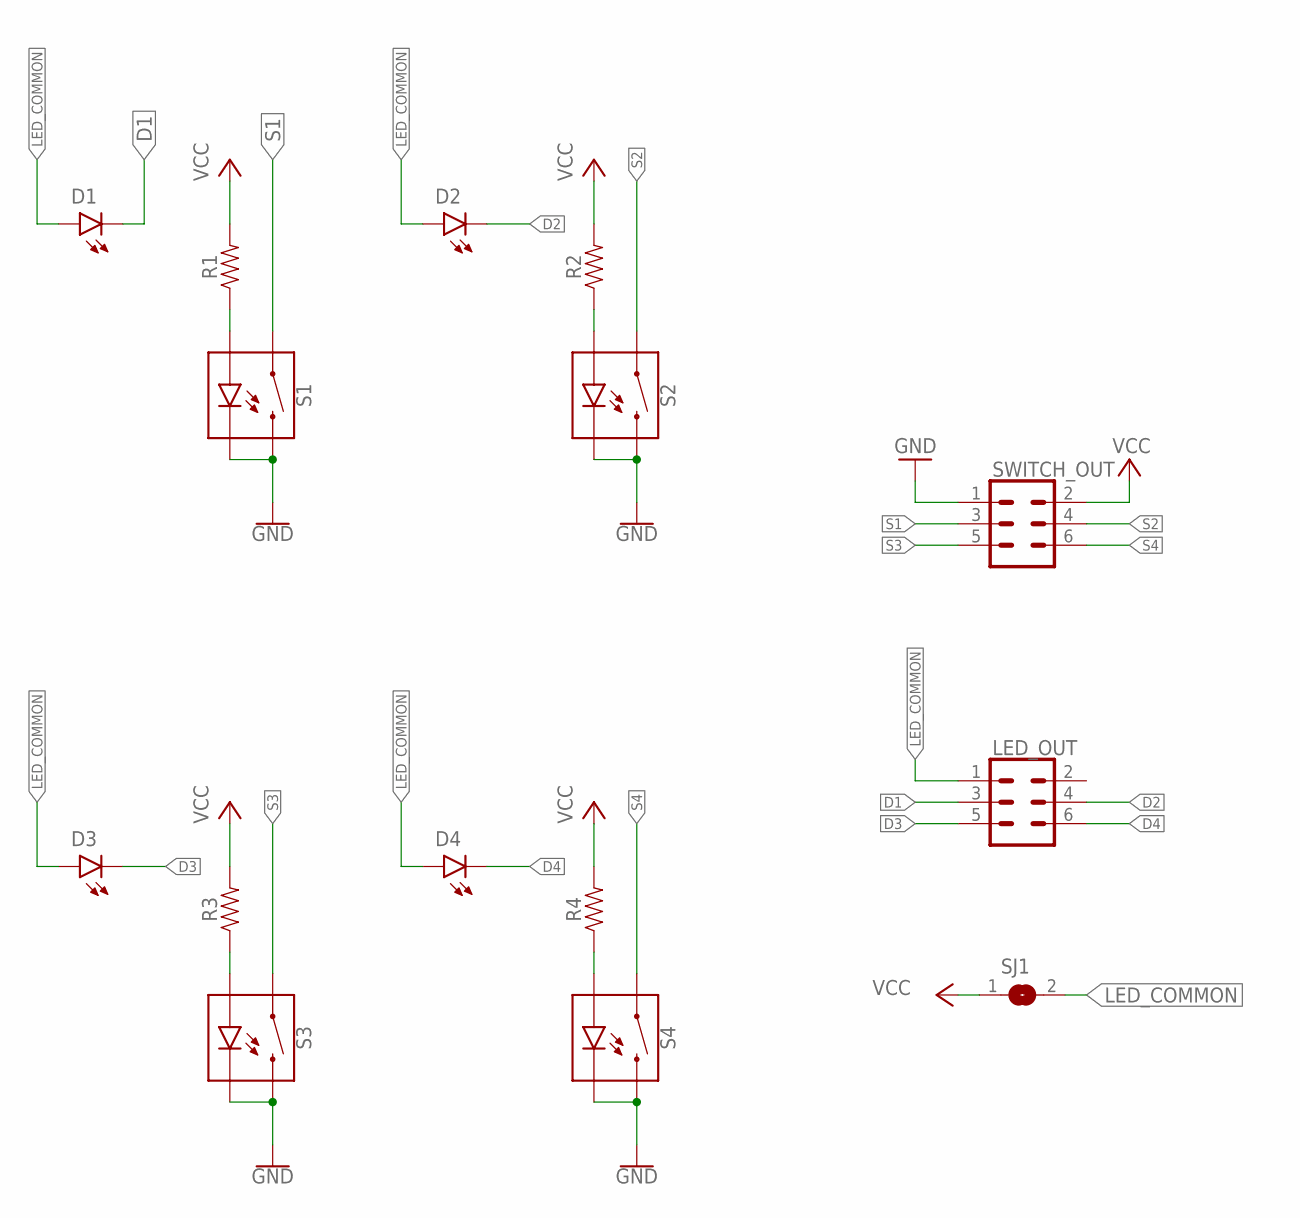
[picture p23: schematic 4_Button_Array_LED_V2.sch]

Parts:
D1, D2, D3, D4: LED3MM; LED_3MM
LED_OUT: CONN_03X2SHROUD; 2X3-SHROUDED
R1, R2, R3, R4: 1206
S1, S2, S3, S4: MOMENTARY-SWITCH-SPST-LED-PTH-12MM; TACTILE_SWITCH_LED_PTH_12MM
SJ1: SJ
SWITCH_OUT: CONN_03X2SHROUD; 2X3-SHROUDED

Connections:
D1: D1.K (C), LED_OUT.3
D2: D2.K (C), LED_OUT.4
D3: D3.K (C), LED_OUT.5
D4: D4.K (C), LED_OUT.6
GND: S1.2, S1.C, S2.2, S2.C, S3.2, S3.C, S4.2, S4.C, SWITCH_OUT.1
LED_COMMON: D1.A, D2.A, D3.A, D4.A, LED_OUT.1, SJ1.2
unnamed: R2.1, S2.A
unnamed: R1.1, S1.A
unnamed: R3.1, S3.A
unnamed: R4.1, S4.A
S1: S1.4 (1), SWITCH_OUT.3
S2: S2.4 (1), SWITCH_OUT.4
S3: S3.4 (1), SWITCH_OUT.5
S4: S4.4 (1), SWITCH_OUT.6
VCC: R1.2, R2.2, R3.2, R4.2, SJ1.1, SWITCH_OUT.2
