smc8050/MSFS2020_Homecockpit/PCB/projects/4_Button_Array_LED_V2/4_Button_Array_LED_V2.brd

## EAGLE design PCB/projects/4_Button_Array_LED_V2/4_Button_Array_LED_V2.brd (continued)

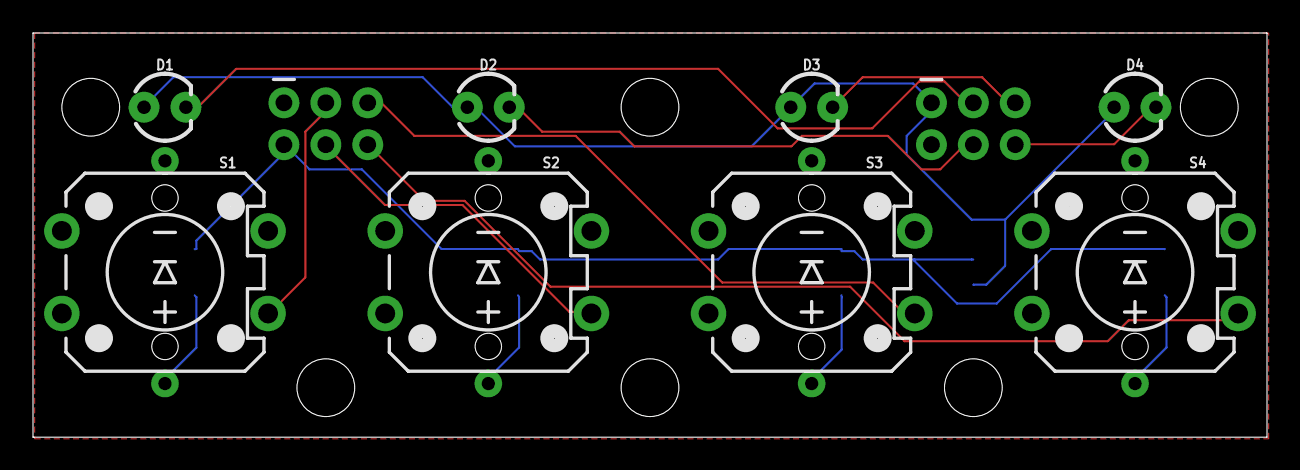
[picture p24: board 4_Button_Array_LED_V2.brd from above]

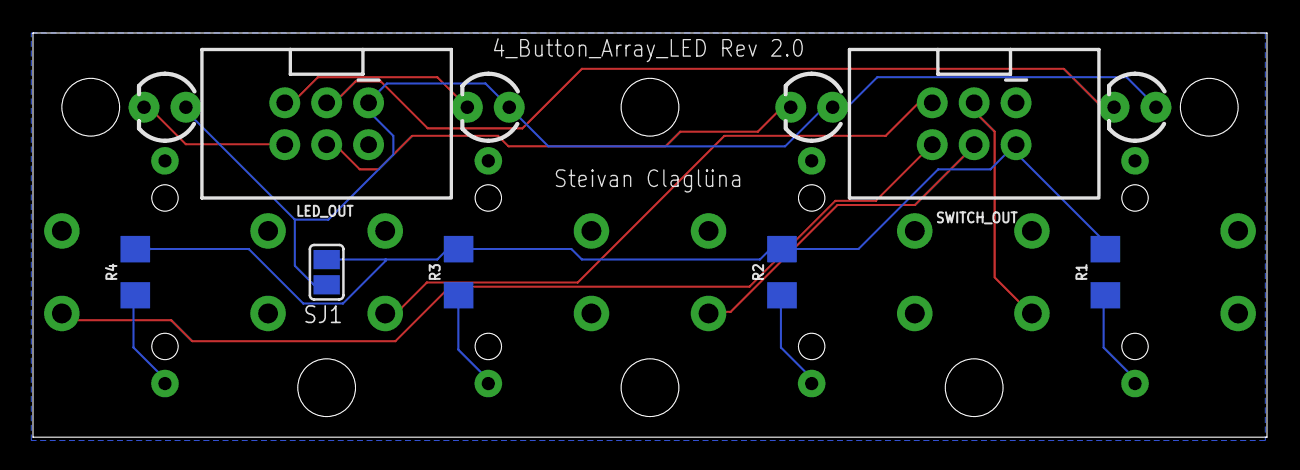
[picture p25: board 4_Button_Array_LED_V2.brd from below]

Board: 2 copper layers, 74.8 x 24.5 mm, 15 parts (7 on the bottom side), 15 nets.
