smc8050/MSFS2020_Homecockpit/PCB/projects/Arduino_Mega_Shield/Cockpit-shield.brd

## EAGLE design PCB/projects/Arduino_Mega_Shield/Cockpit-shield.brd (2021-01-24)

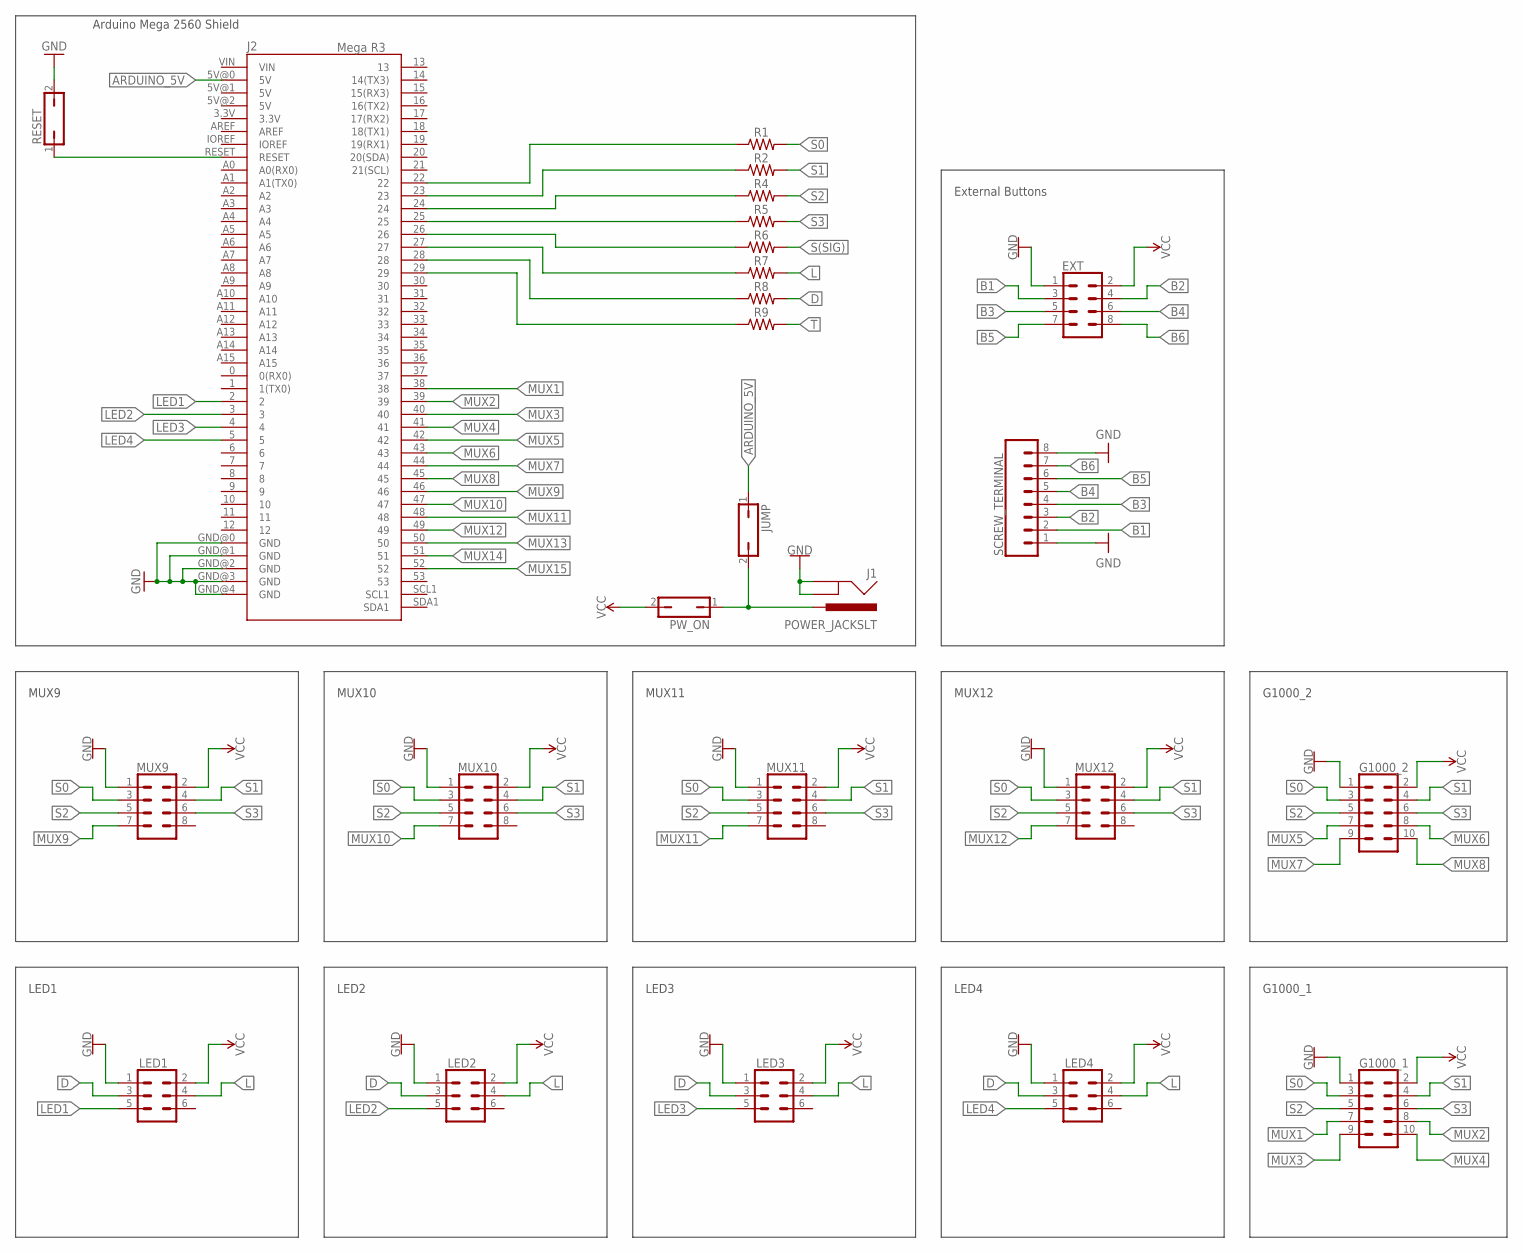
[picture p26: schematic Cockpit-shield.sch]

Parts:
EXT: CONN_04X2; 2X4
G1000_1, G1000_2: CONN_05X2SHD-NS; 2X5-SHROUDED-NS
J1: POWER_JACKSLT; POWER_JACK_SLOT
J2: Mega R3; ARDUINO_MEGA
JUMP: JP1Q; JP1
LED1, LED2, LED3, LED4: CONN_03X2NO_SILK; 2X3-NS
MUX9, MUX10, MUX11, MUX12: CONN_04X2; 2X4
PW_ON: JP1Q; JP1
R1, R2, R4, R5, R6, R7, R8, R9: 1206
RESET: JP1Q; JP1
SCREW_TERMINAL: CONN_083.5MM-8; SCREWTERMINAL-3.5MM-8

Connections:
ARDUINO_5V: J2.5V@0 (5V), JUMP.1
B1: EXT.3, SCREW_TERMINAL.2
B2: EXT.4, SCREW_TERMINAL.3
B3: EXT.5, SCREW_TERMINAL.4
B4: EXT.6, SCREW_TERMINAL.5
B5: EXT.7, SCREW_TERMINAL.6
B6: EXT.8, SCREW_TERMINAL.7
D: LED1.3, LED2.3, LED3.3, LED4.3, R8.2
GND: EXT.1, G1000_1.1, G1000_2.1, J1.GND@1 (GNDBREAK), J1.GND@2 (GND), J2.GND@0 (GND), J2.GND@1 (GND), J2.GND@2 (GND), J2.GND@3 (GND), J2.GND@4 (GND), LED1.1, LED2.1, LED3.1, LED4.1, MUX9.1, MUX10.1, MUX11.1, MUX12.1, RESET.2, SCREW_TERMINAL.1, SCREW_TERMINAL.8
L: LED1.4, LED2.4, LED3.4, LED4.4, R7.2
LED1: J2.2, LED1.5
LED2: J2.3, LED2.5
LED3: J2.4, LED3.5
LED4: J2.5, LED4.5
MUX1: G1000_1.7, J2.38
MUX2: G1000_1.8, J2.39
MUX3: G1000_1.9, J2.40
MUX4: G1000_1.10, J2.41
MUX5: G1000_2.7, J2.42
MUX6: G1000_2.8, J2.43
MUX7: G1000_2.9, J2.44
MUX8: G1000_2.10, J2.45
MUX9: J2.46, MUX9.7
MUX10: J2.47, MUX10.7
MUX11: J2.48, MUX11.7
MUX12: J2.49, MUX12.7
MUX13: J2.50
MUX14: J2.51
MUX15: J2.52
unnamed: J2.22, R1.1
unnamed: J2.23, R2.1
unnamed: J2.24, R4.1
unnamed: J2.25, R5.1
unnamed: J2.26, R6.1
unnamed: J2.27, R7.1
unnamed: J2.28, R8.1
unnamed: J2.29, R9.1
unnamed: J1.PWR, JUMP.2, PW_ON.1
RESET: J2.RESET, RESET.1
S0: G1000_1.3, G1000_2.3, MUX9.3, MUX10.3, MUX11.3, MUX12.3, R1.2
S1: G1000_1.4, G1000_2.4, MUX9.4, MUX10.4, MUX11.4, MUX12.4, R2.2
S2: G1000_1.5, G1000_2.5, MUX9.5, MUX10.5, MUX11.5, MUX12.5, R4.2
S3: G1000_1.6, G1000_2.6, MUX9.6, MUX10.6, MUX11.6, MUX12.6, R5.2
S(SIG): R6.2
T: R9.2
VCC: EXT.2, G1000_1.2, G1000_2.2, LED1.2, LED2.2, LED3.2, LED4.2, MUX9.2, MUX10.2, MUX11.2, MUX12.2, PW_ON.2

Notes on the sheet:
Arduino Mega 2560 Shield
G1000_1
G1000_2
MUX9
MUX10
MUX11
MUX12
LED1
LED2
LED3
LED4
External Buttons

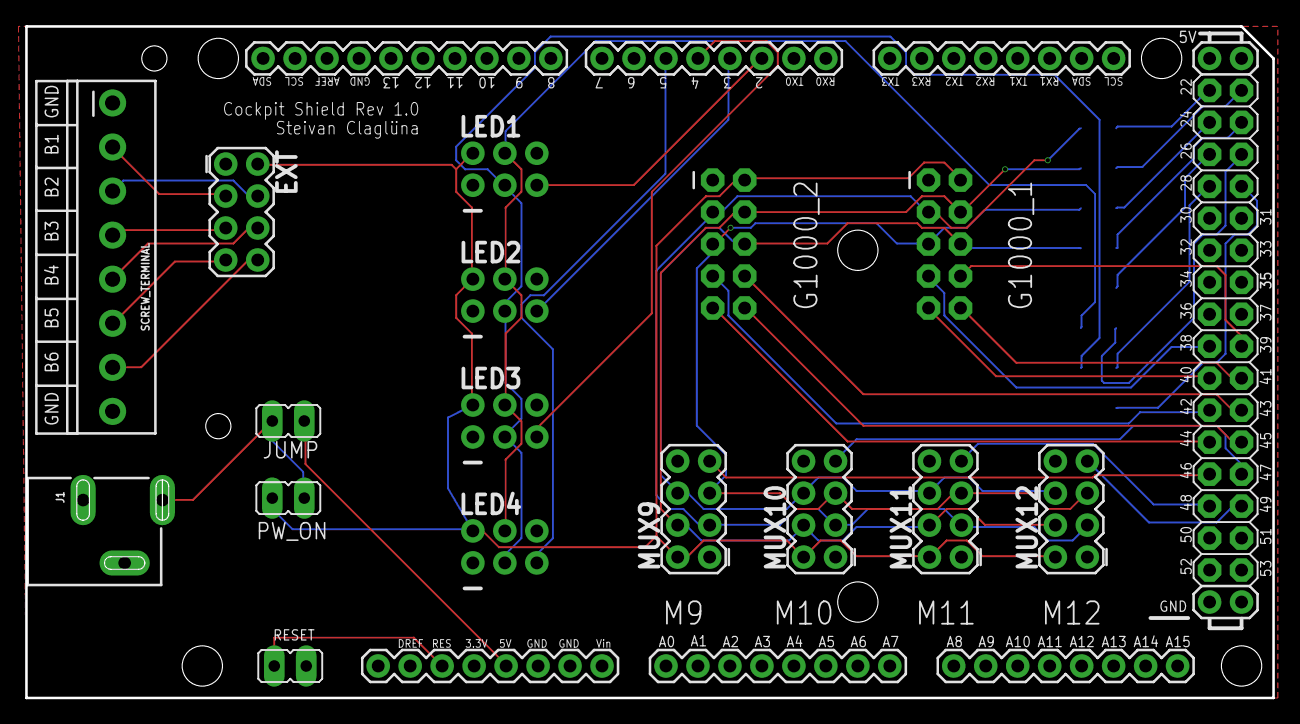
[picture p27: board Cockpit-shield.brd from above]

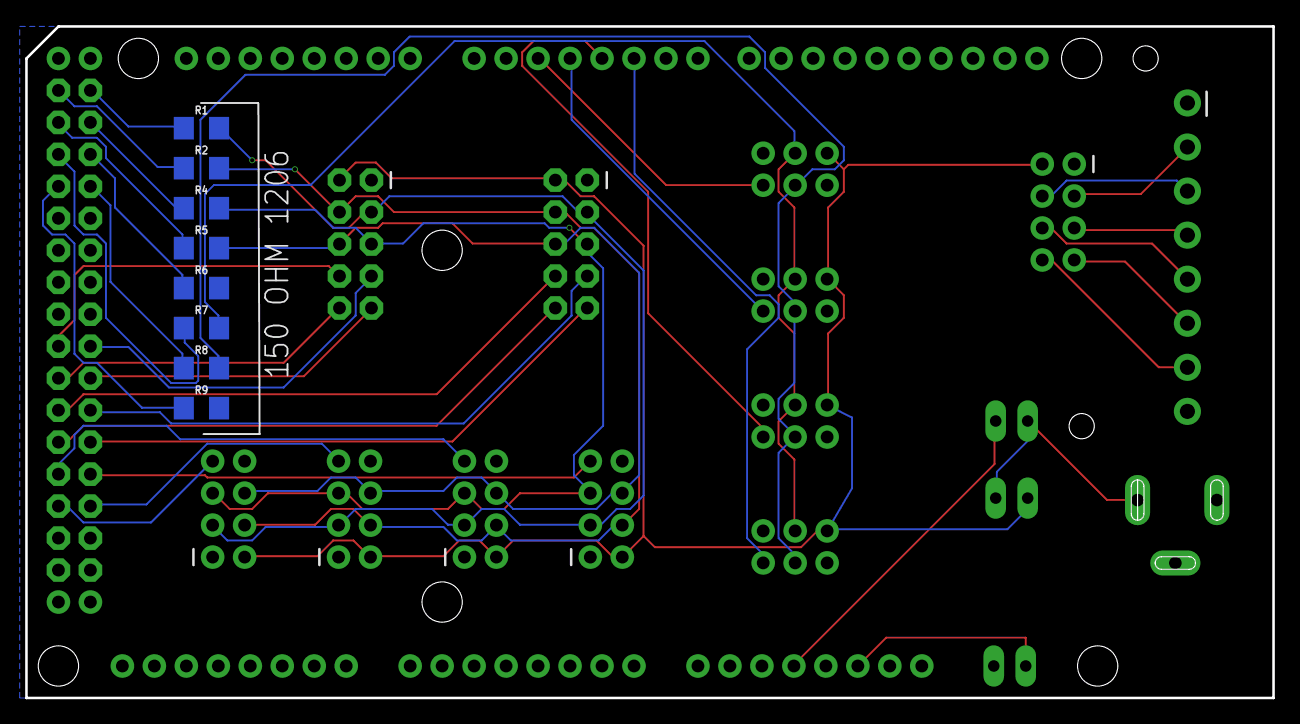
[picture p28: board Cockpit-shield.brd from below]

Board: 2 copper layers, 99.1 x 53.3 mm, 25 parts (8 on the bottom side), 41 nets.
