smc8050/MSFS2020_Homecockpit/(commit log)

2021-01-24 Initial upload of PCB files
    Initial upload of all PCB, libraries and ulp's for EAGLE CAD
    [4_Button_Array_LED.brd, 4_Button_Array_LED.sch, 4_Button_Array_LED_V2.brd, 4_Button_Array_LED_V2.sch, 6_Button_Array.brd, 6_Button_Array.sch, Coax_Encoder.brd, Coax_Encoder.sch]
2021-01-24 Update and rename PCB_files.md to PCB_README.md
2021-02-19 Added multiplexed encoders support
2021-02-19 Added encoders_commands
2021-02-25 added multiplexed encoder library
2021-02-25 replaced Excel file with CSV file for configuration
    [Cockpit_config.CSV]
2021-02-25 Delete MUX_Pinout.xlsm
    replaced with CSV file in the Python folder
    [MUX_Pinout.xlsm]
2021-02-25 Delete encodersetup.h
    integrated to cockpit_io.h
